kristofvl/NetWirelessIMU/Reference/nRF54L01_Reference/nRF_Castellations/nRF_C2.jpg

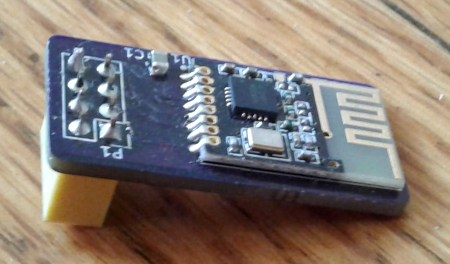
Reference/nRF54L01_Reference/nRF_Castellations/nRF_C2.jpg
