kristofvl/NetWirelessIMU/Reference/nRF54L01_Reference/nRF_Castellations/nRF_C1.jpg

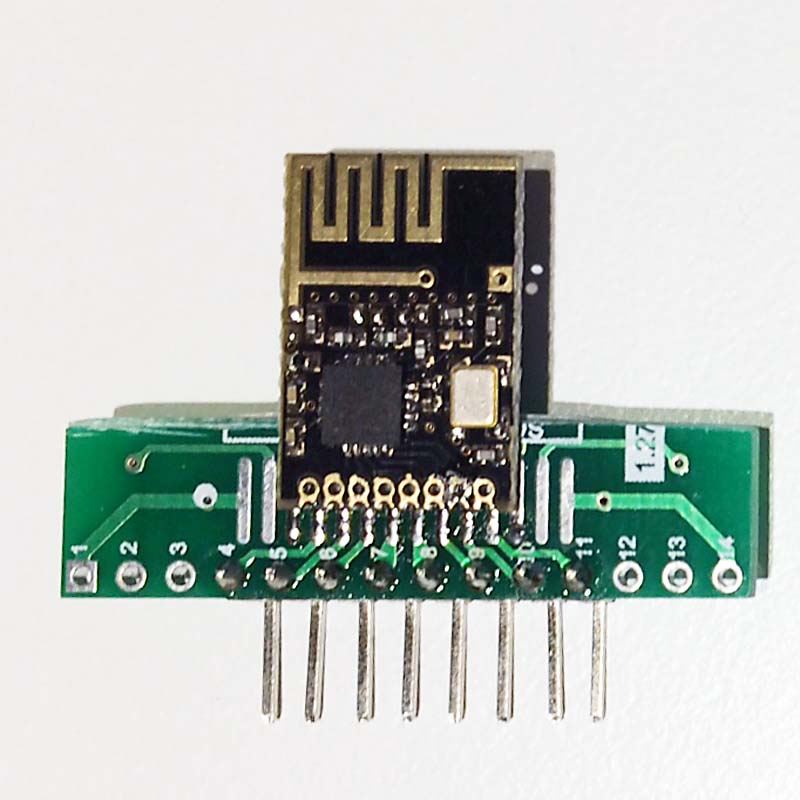
Reference/nRF54L01_Reference/nRF_Castellations/nRF_C1.jpg
