kristofvl/NetWirelessIMU/README.md

# Networked Wireless IMUs

A project started by Frederic Philips as a Masters thesis, now continued to update a hardware/software system of networked IMUs.
