kristofvl/NetWirelessIMU/Nextion/Nextion_Images/2_Nodes_Green.png

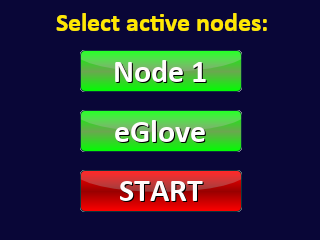
Nextion/Nextion_Images/2_Nodes_Green.png
