kristofvl/NetWirelessIMU/Nextion/Nextion_Images/2_Nodes_Grey.png

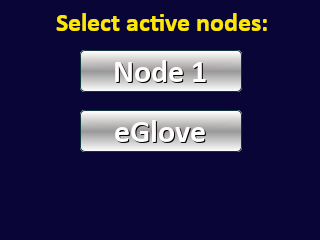
Nextion/Nextion_Images/2_Nodes_Grey.png
