kristofvl/NetWirelessIMU/Nextion/Nextion_Images/Abstact_Dark.jpg

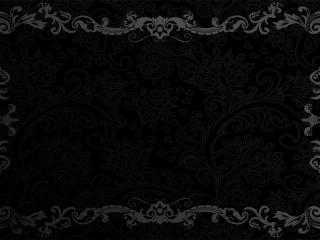
Nextion/Nextion_Images/Abstact_Dark.jpg
