kristofvl/NetWirelessIMU/Nextion/Nextion_Images/eGlove.png

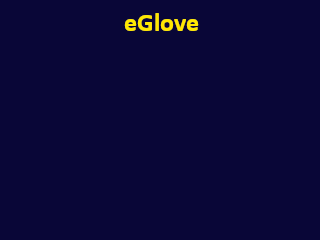
Nextion/Nextion_Images/eGlove.png
