kristofvl/NetWirelessIMU/Nextion/Nextion_Images/Nextion_Blue.jpg

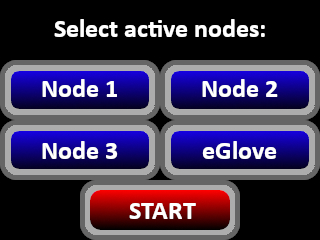
Nextion/Nextion_Images/Nextion_Blue.jpg
