kristofvl/NetWirelessIMU/Nextion/Nextion_Images/Nextion_Green.jpg

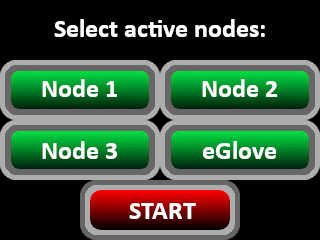
Nextion/Nextion_Images/Nextion_Green.jpg
