kristofvl/NetWirelessIMU/Nextion/Nextion_Images/Node1_eGlove.png

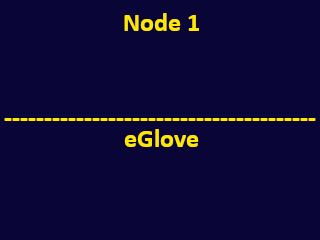
Nextion/Nextion_Images/Node1_eGlove.png
