kristofvl/NetWirelessIMU/PCB/Reference_PCBs/ATmega32U4_PCB/Adafruit_Feather_32u4_Basic_Proto/Adafruit_Feather_32u4_Schematic.png

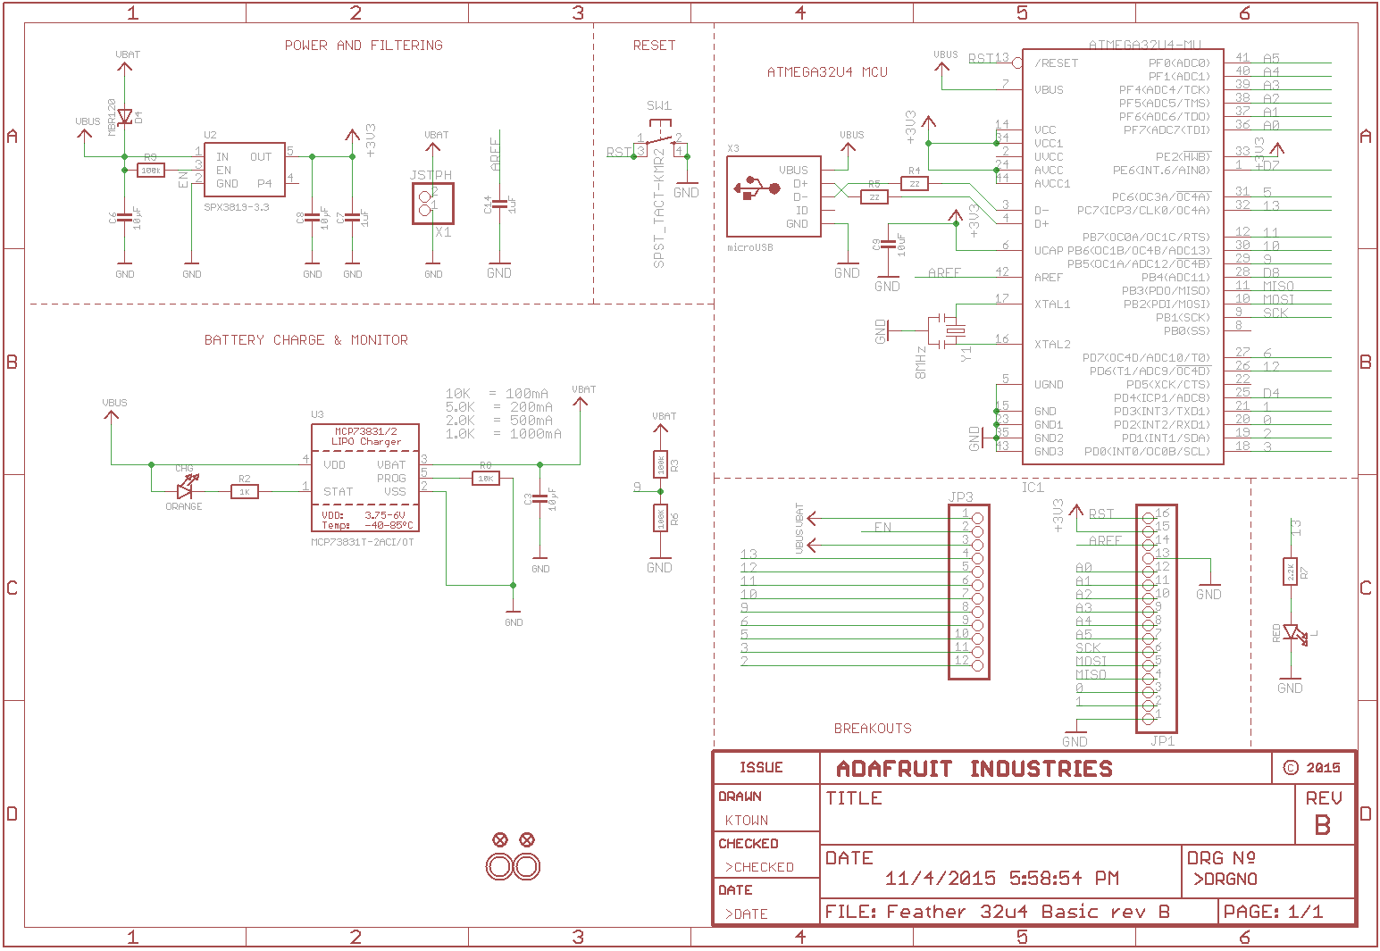
PCB/Reference_PCBs/ATmega32U4_PCB/Adafruit_Feather_32u4_Basic_Proto/Adafruit_Feather_32u4_Schematic.png
