kristofvl/NetWirelessIMU/PCB/Reference_PCBs/MCP73831_LiPo_Charger_PCB/Adafruit_MiniLipo/Adafruit_MiniLipo_Schematic.png

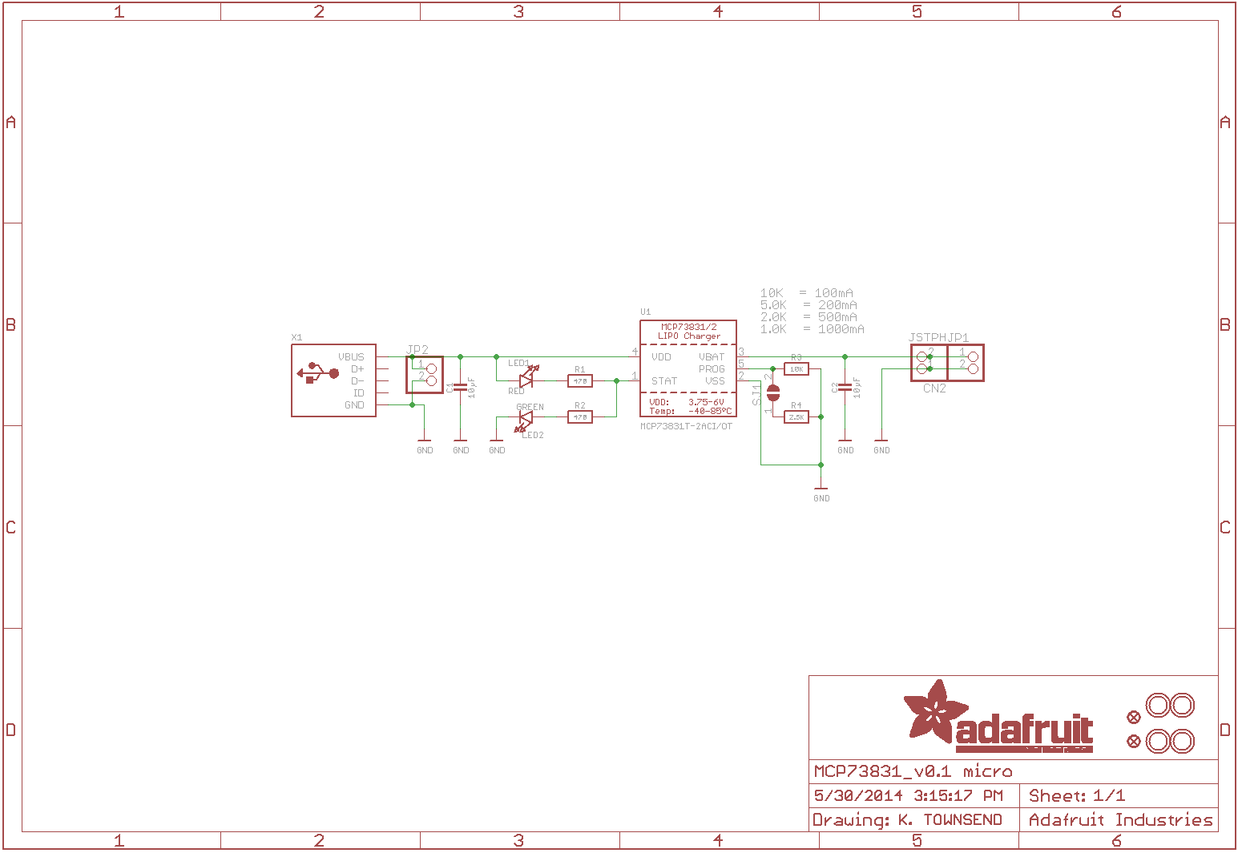
PCB/Reference_PCBs/MCP73831_LiPo_Charger_PCB/Adafruit_MiniLipo/Adafruit_MiniLipo_Schematic.png
