kristofvl/NetWirelessIMU/Reference/BNO055_Reference/BNO055_Shuttleboard_Schematic.png

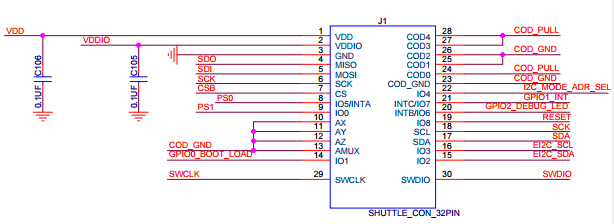
Reference/BNO055_Reference/BNO055_Shuttleboard_Schematic.png
