kristofvl/NetWirelessIMU/Reference/BNO055_Reference/I2C_connection_diagram.png

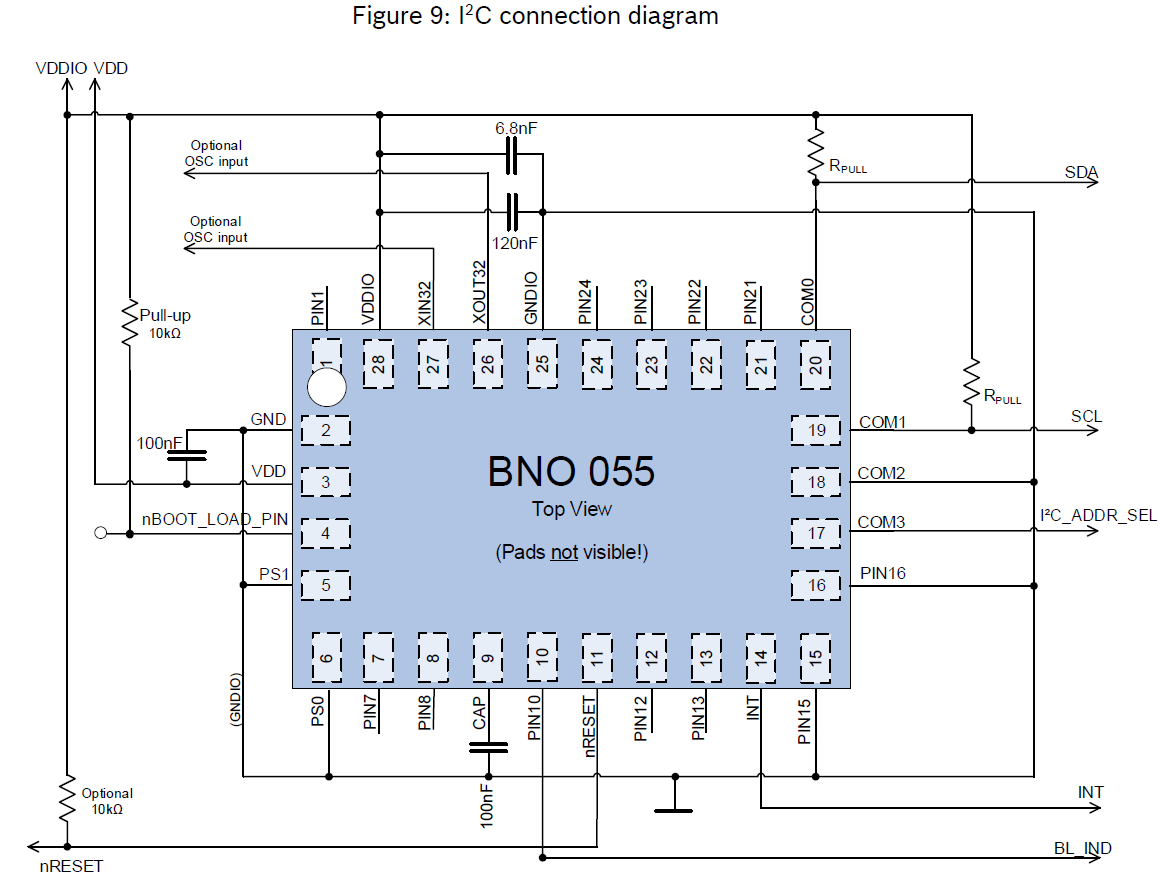
Reference/BNO055_Reference/I2C_connection_diagram.png
