kristofvl/NetWirelessIMU/Python_Reader/Recordings/calibration.csv

Sensor | 0 | 7 | wrist | OrientationAcceleration
Sensor | 1 | 7 | palm | OrientationAcceleration
Sensor | 2 | 7 | thumb | OrientationAcceleration
Sensor | 3 | 7 | index | OrientationAcceleration
Sensor | 4 | 7 | mid | OrientationAcceleration
Sensor | 5 | 7 | ring | OrientationAcceleration
Sensor | 6 | 7 | pinky | OrientationAcceleration
0 | 0 | -0.6142578125 | 0.734375 | 0.23187255859375 | -0.17218017578125 | 0.03 | -0.06 | -0.17
1 | 5 | 0.652099609375 | -0.65484619140625 | -0.24444580078125 | 0.29351806640625 | 0.2 | -0.03 | -0.1
2 | 6 | 0.5740966796875 | -0.774658203125 | 0.00372314453125 | -0.26507568359375 | 0.02 | 0.32 | -0.07
0 | 7 | -0.61419677734375 | 0.73431396484375 | 0.23199462890625 | -0.17236328125 | 0.02 | -0.05 | -0.15
3 | 11 | 0.7589111328125 | -0.54754638671875 | -0.30389404296875 | 0.1787109375 | 0.28 | -0.05 | -0.29
4 | 11 | 0.808349609375 | -0.50946044921875 | -0.2322998046875 | 0.18170166015625 | 0.24 | 0.05 | -0.35
5 | 17 | 0.77496337890625 | -0.53076171875 | -0.28680419921875 | 0.1884765625 | 0.18 | 0.0 | -0.11
6 | 18 | -0.72760009765625 | 0.59716796875 | 0.1893310546875 | -0.279541015625 | 0.21 | 0.02 | -0.22
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
