kristofvl/NetWirelessIMU/Reference/nRF_test.pdf

nRF_TX_test | nRF_RX_test

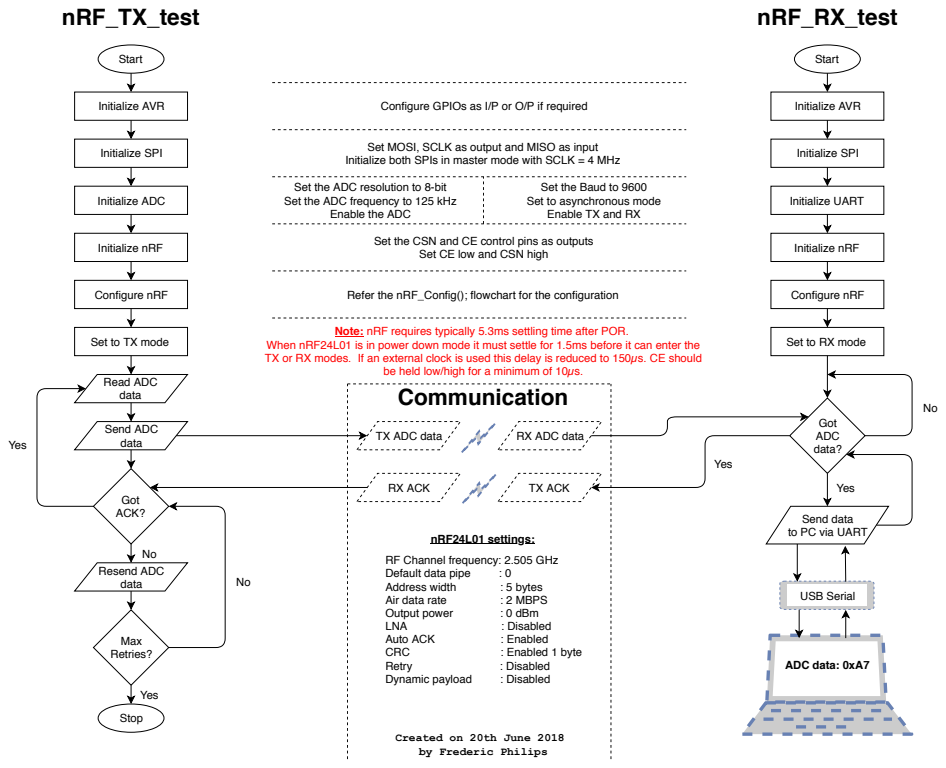
[picture p14: page 1]
Start; Initialize AVR; Initialize SPI; Initialize ADC; Initialize nRF; Configure nRF; Read ADC data; Send ADC data; Got ACK?; Max Retries?; Resend ADC data; Stop; Yes; Initialize UART; TX ADC data; RX ADC data; Got ADC data?; RX ACK; TX ACK; ADC data: 0xA7; USB Serial; Default data pipe; Address width; : 5 bytes; Air data rate; : 2 MBPS; Output power; : 0 dBm; LNA; : Disabled; Auto ACK; : Enabled; CRC; : Enabled 1 byte; Retry; Dynamic payload; nRF24L01 settings:

Configure GPIOs as I/P or O/P if required

Set MOSI, SCLK as output and MISO as input
Initialize both SPIs in master mode with SCLK = 4 MHz

Set the ADC resolution to 8-bit
Set the ADC frequency to 125 kHz

Set the Baud to 9600
Set to asynchronous mode
Enable TX and RX

Enable the ADC

Set the CSN and CE control pins as outputs

Set CE low and CSN high

Refer the nRF_Config(); flowchart for the configuration

Note: nRF requires typically 5.3ms settling time after POR.

Set to TX mode

Set to RX mode

When nRF24L01 is in power down mode it must settle for 1.5ms before it can enter the
TX or RX modes. If an external clock is used this delay is reduced to 150µs. CE should

be held low/high for a minimum of 10µs.
Communication

Send data
to PC via UART

RF Channel frequency: 2.505 GHz

Created on 20th June 2018
by Frederic Philips
