kristofvl/NetWirelessIMU/PCB/Reference_PCBs/MAX17043_Battery_Gauge_PCB/MAX17043_Schematic.pdf

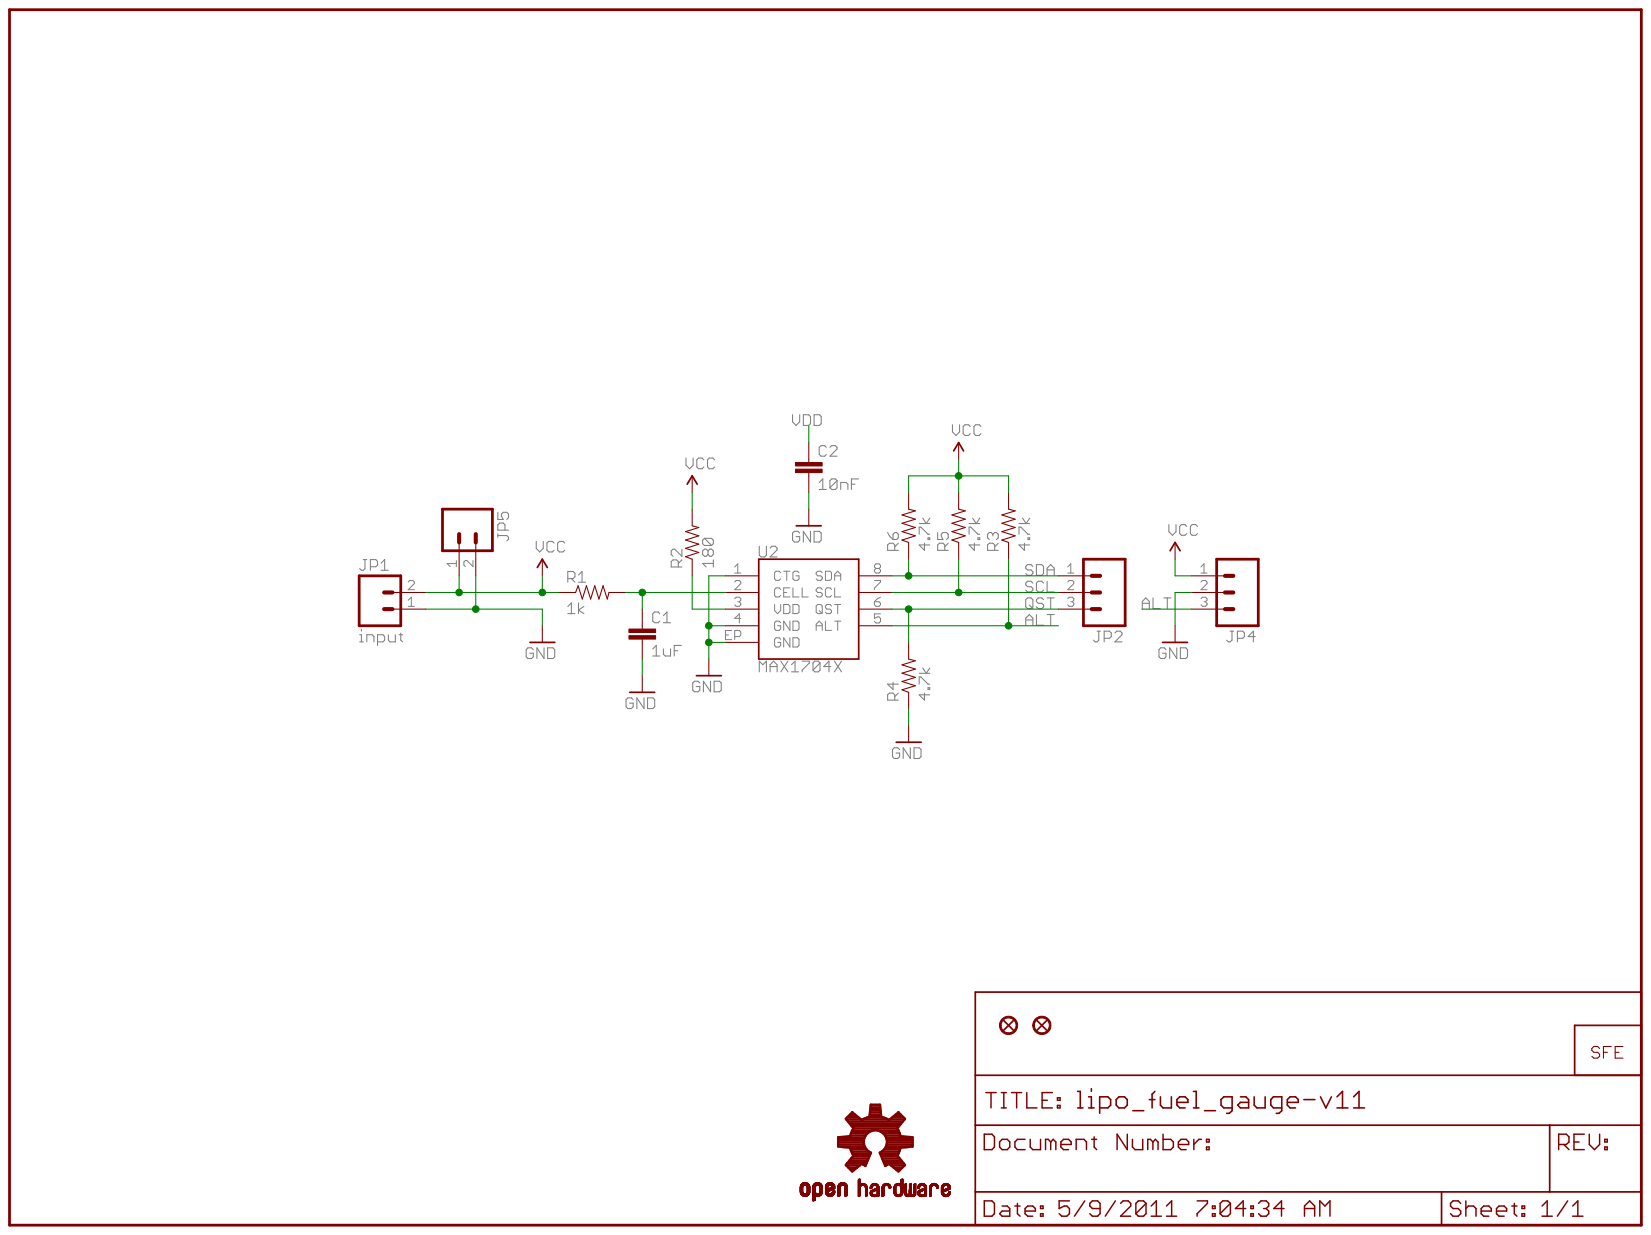
[picture p15: page 1]
