kristofvl/NetWirelessIMU/PCB/Reference_PCBs/nRF24L01+_PCB/Sparkfun_nRF24L01+_Schematic.pdf

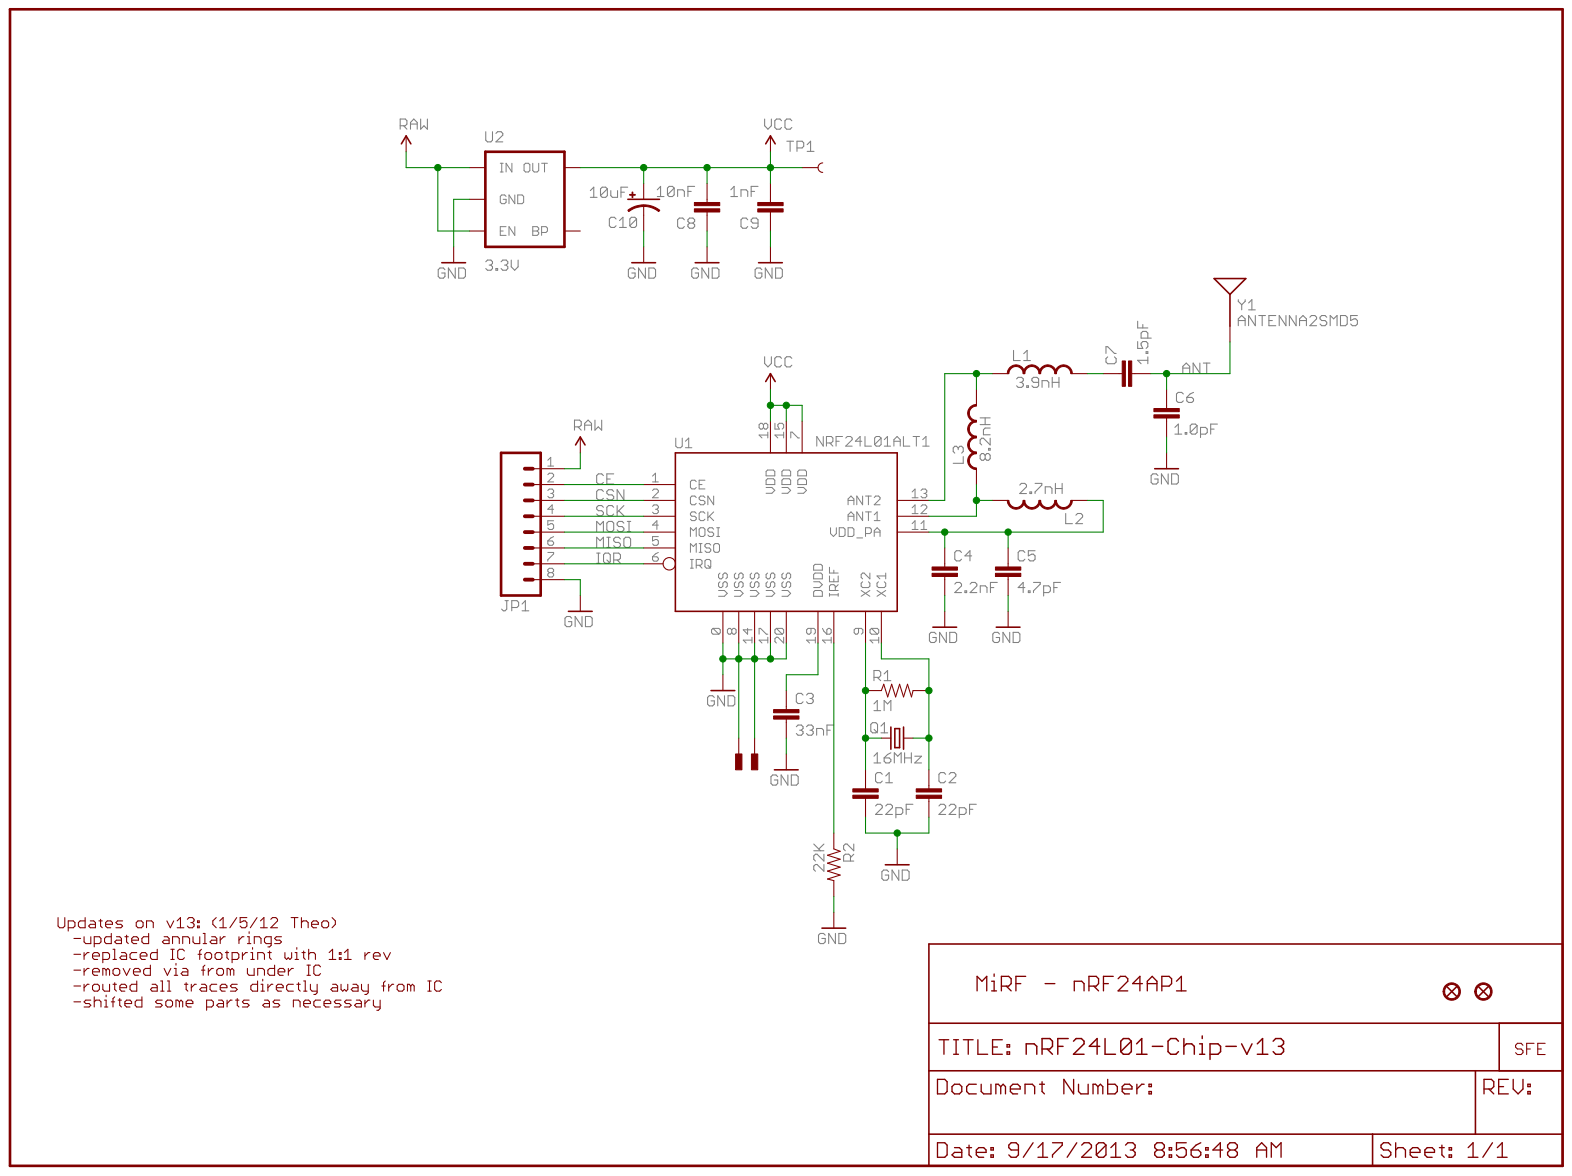
[picture p16: page 1]
