kristofvl/NetWirelessIMU/PCB/Reference_PCBs/ATmega32U4_PCB/Sparkfun_Fio_v3_ATmega32U4/Sparkfun_Fio_Schematic.pdf

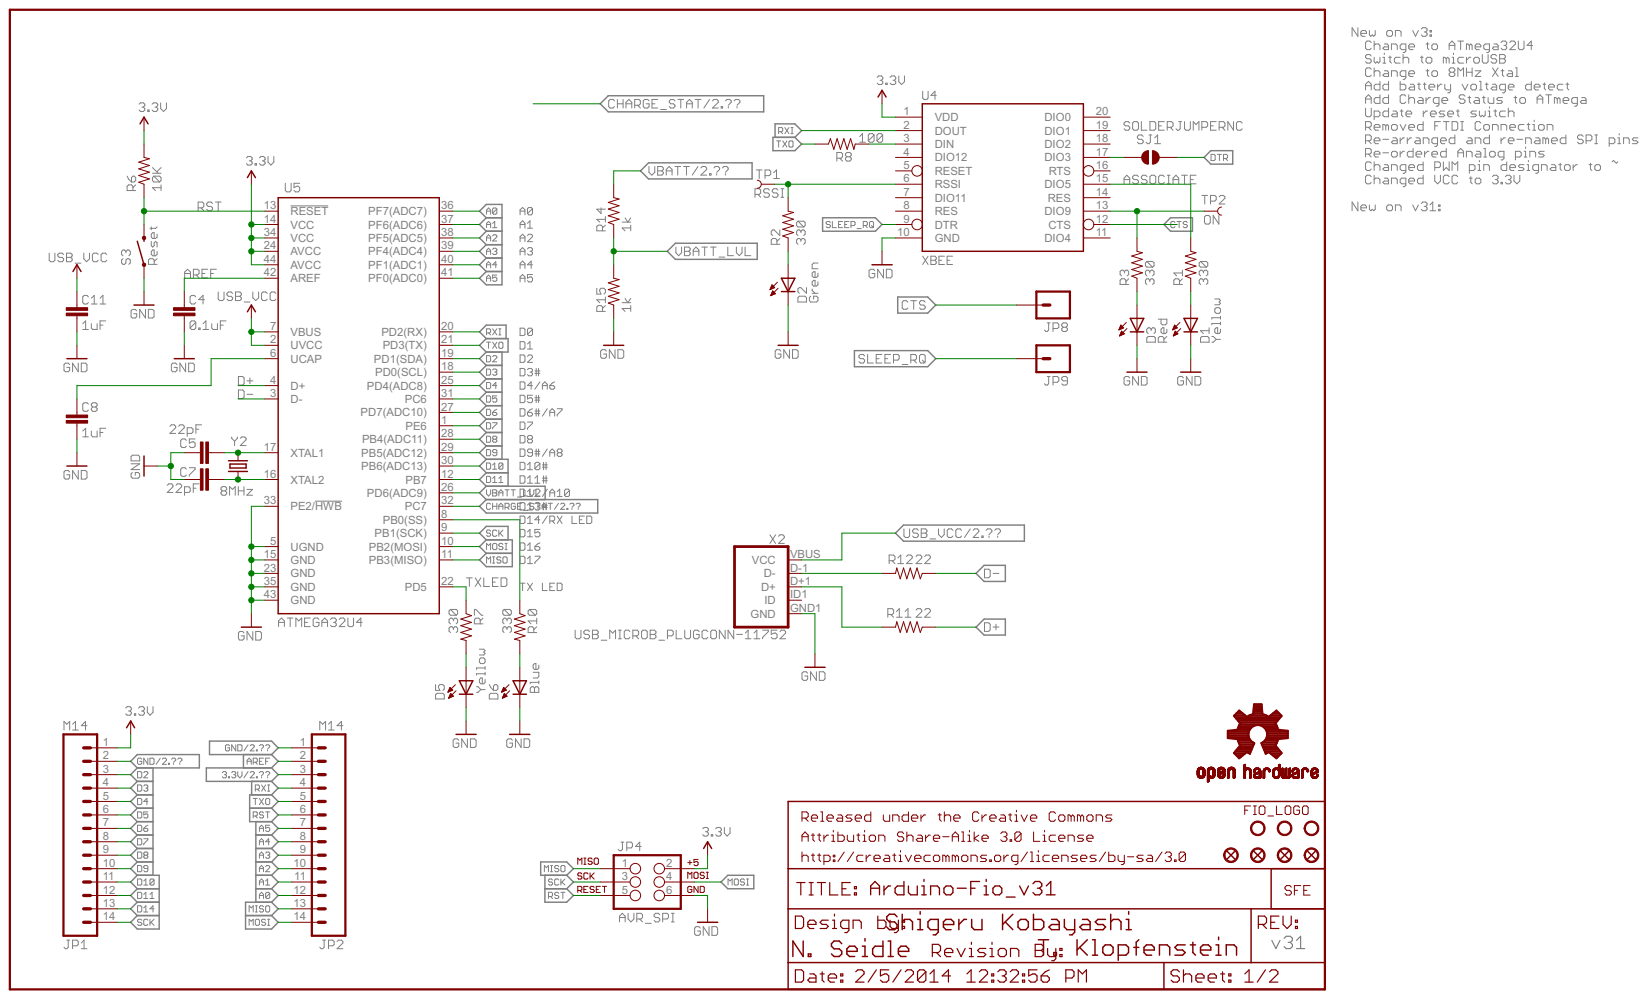
[picture p17: page 1]

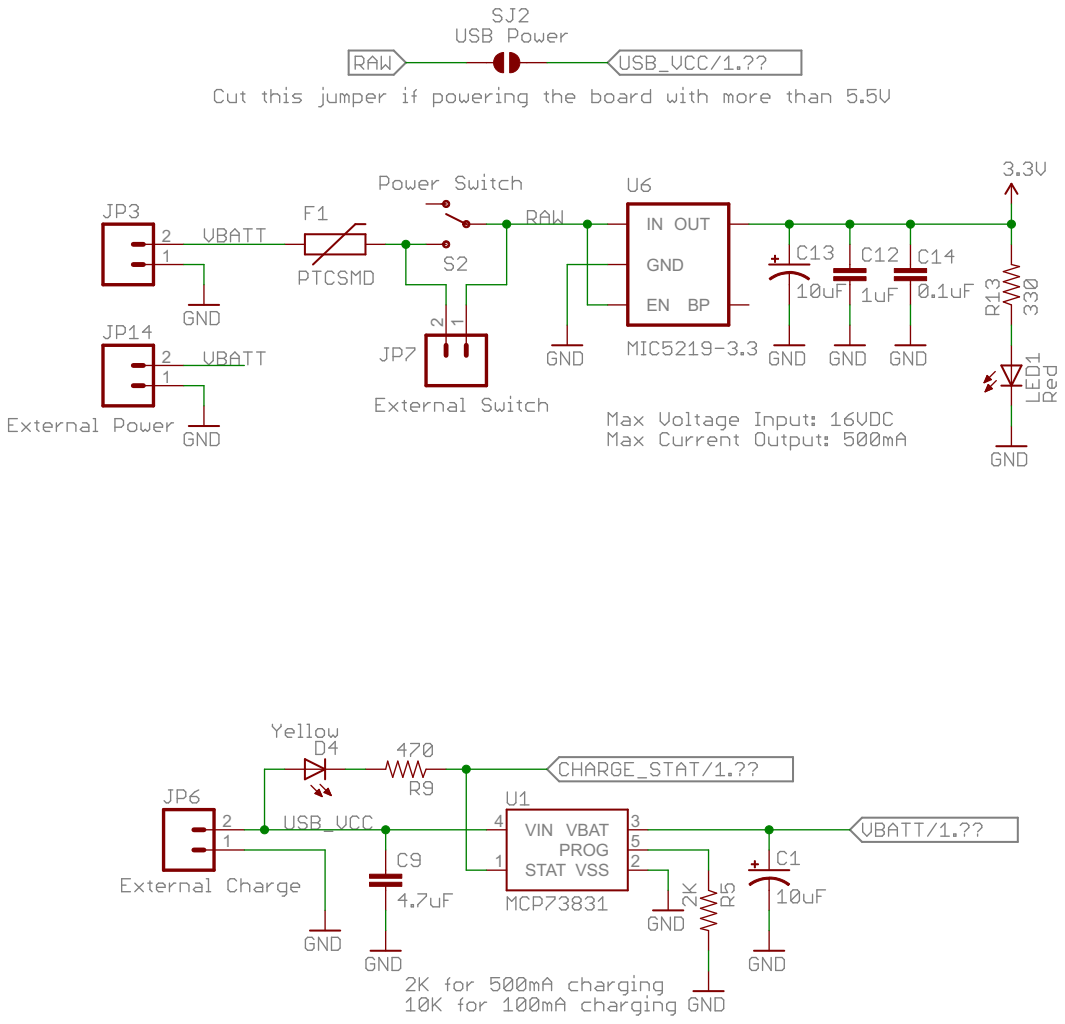
[picture p18: page 2]
