kristofvl/NetWirelessIMU/PCB/Reference_PCBs/MCP73831_LiPo_Charger_PCB/Sparkfun_MiniLipo/Sparkfun_MiniLipo_Schematic.pdf

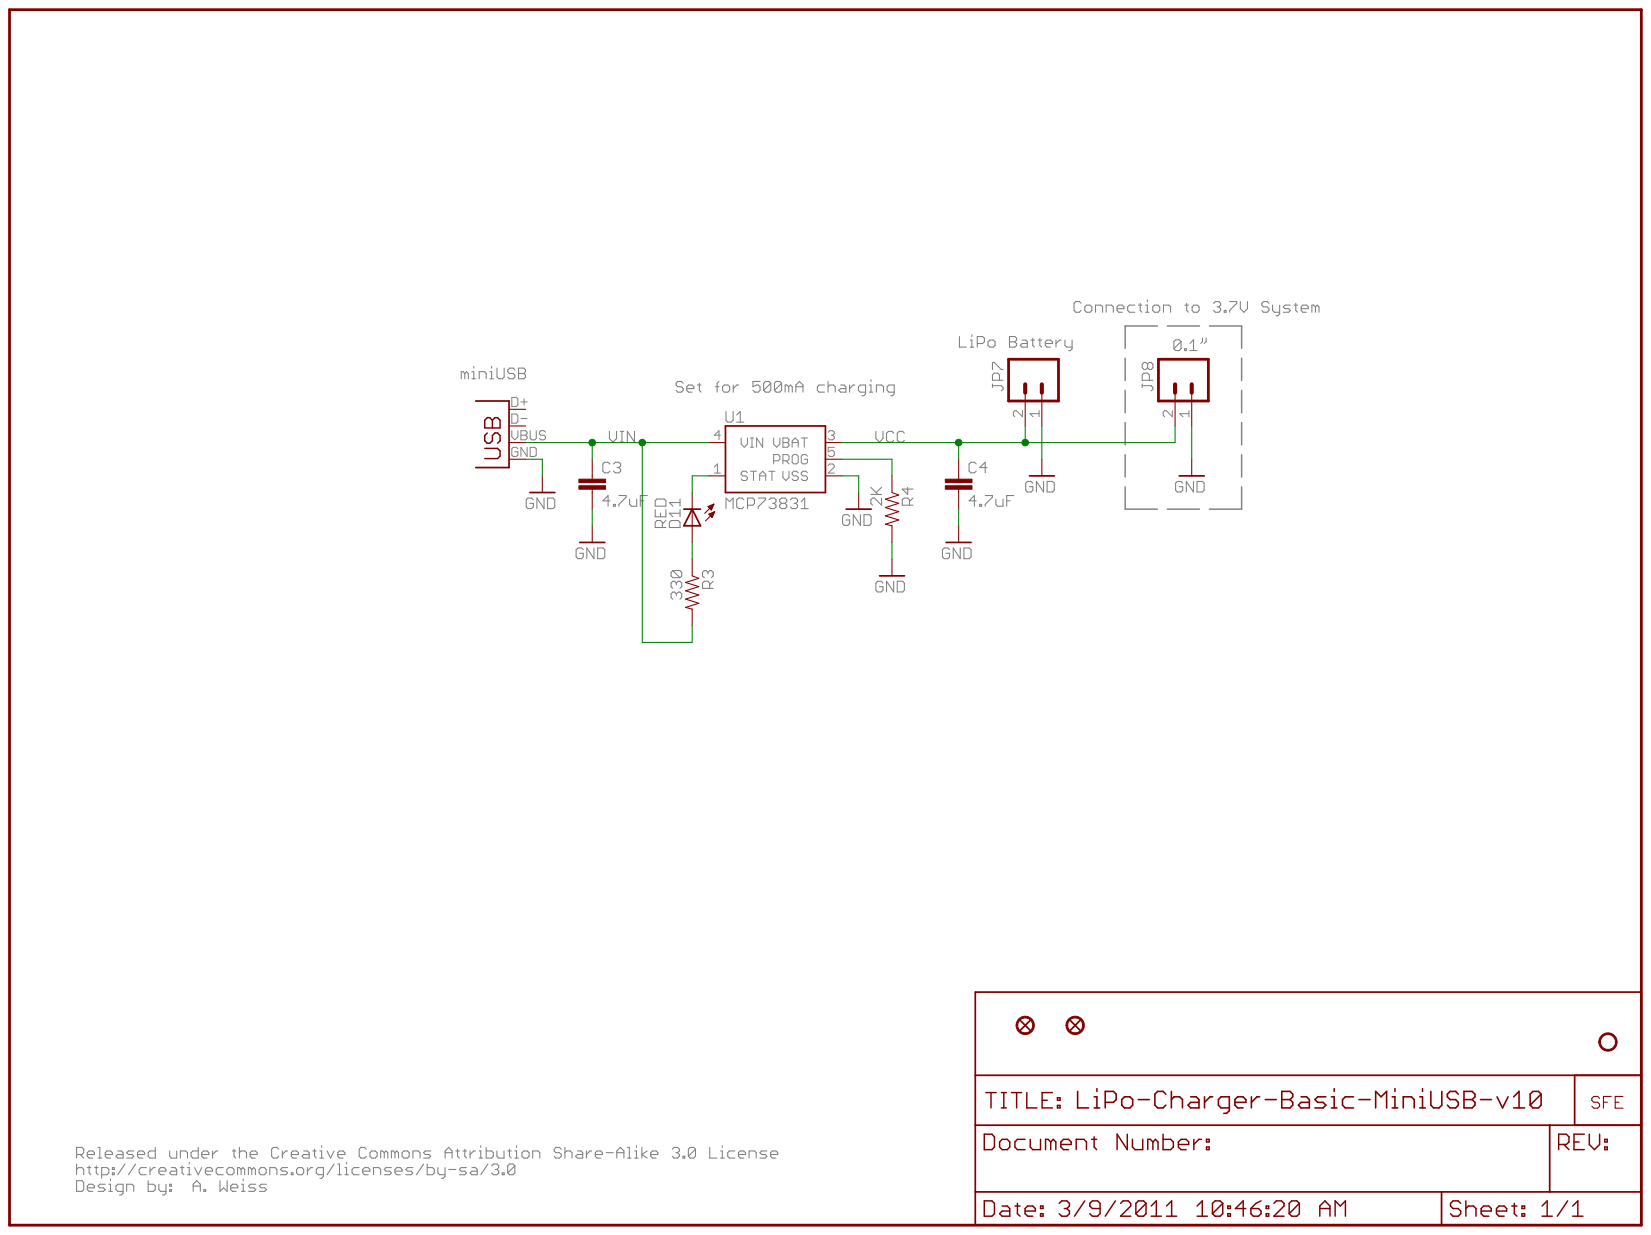
[picture p19: page 1]
