kristofvl/NetWirelessIMU/PCB/PCB_v_2.0/BS_Shield/bs_shield.pdf

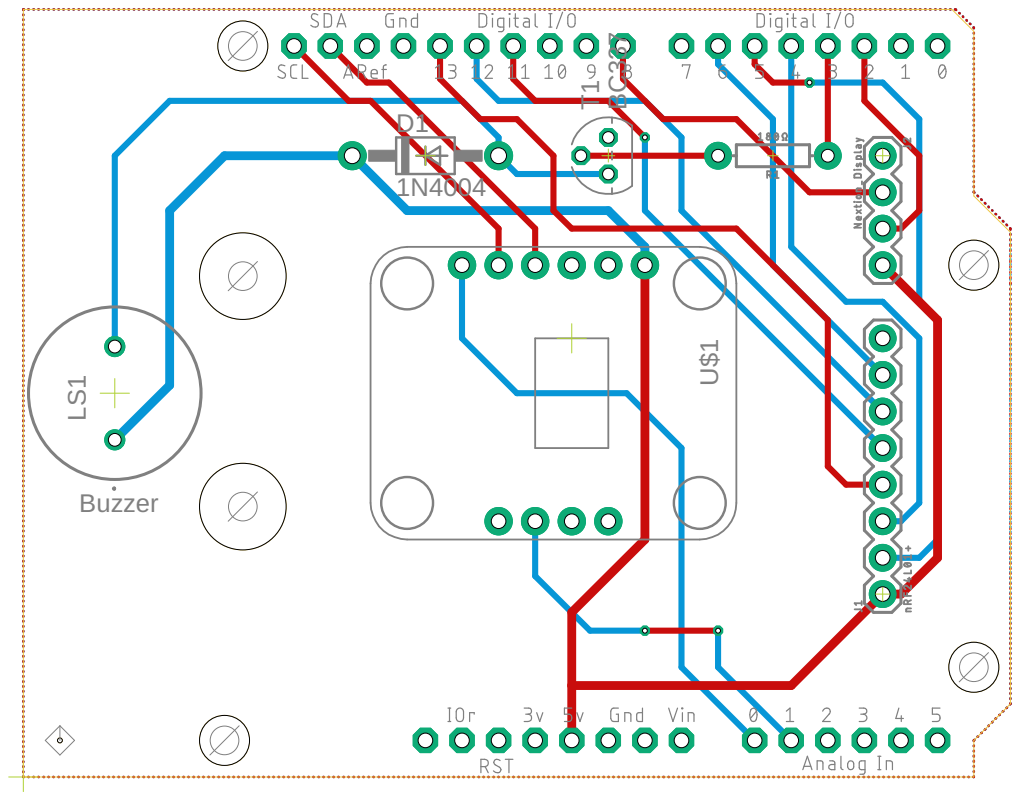
[picture p20: page 1]
