kristofvl/NetWirelessIMU/PCB/PCB_v_2.0/IMU_hand/imu_hand.pdf

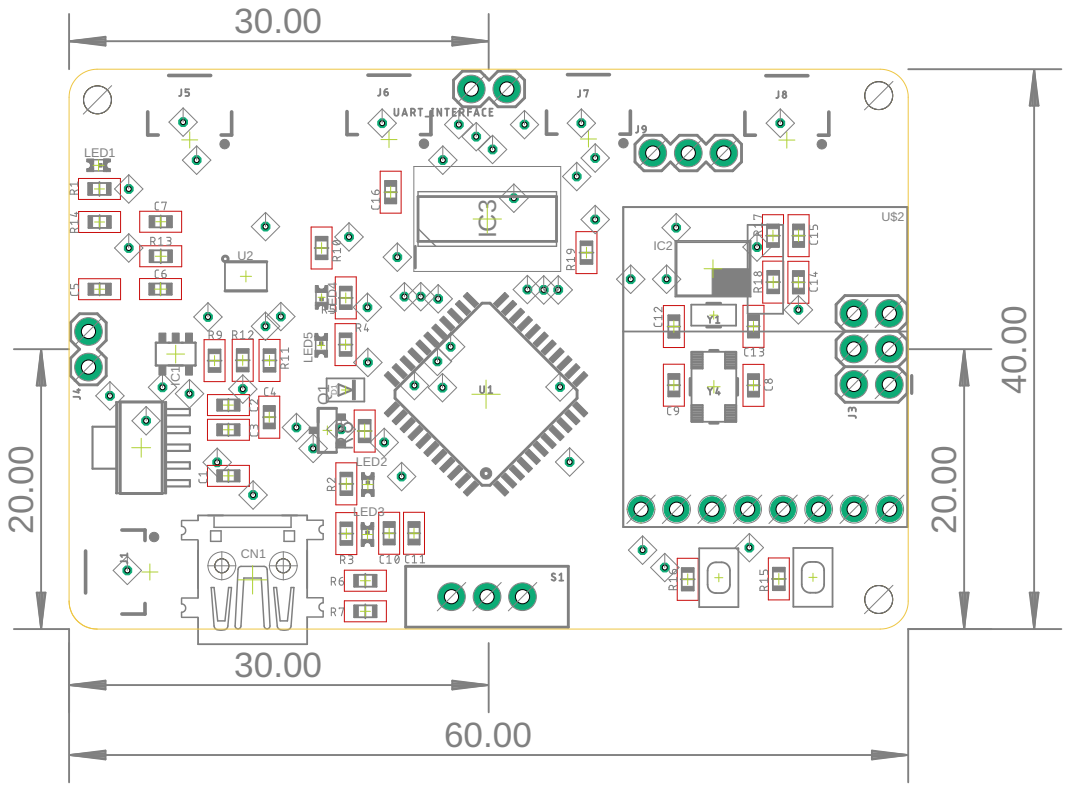
[picture p21: page 1]
