kristofvl/NetWirelessIMU/PCB/PCB_v_2.0/IMU_node/imu_node.pdf

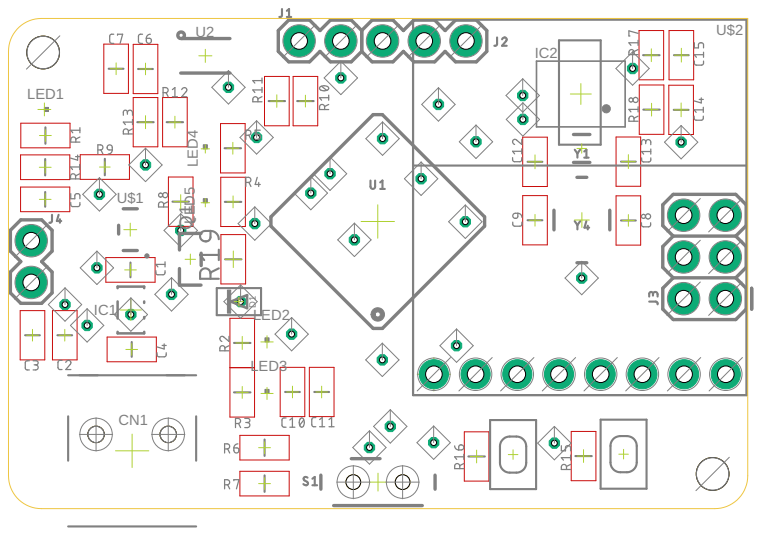
[picture p22: page 1]
