kristofvl/NetWirelessIMU/PCB/PCB_v_1.0/IMU_node/imu_node.brd

## EAGLE design PCB/PCB_v_1.0/IMU_node/imu_node.brd (2018-09-14, an earlier design)

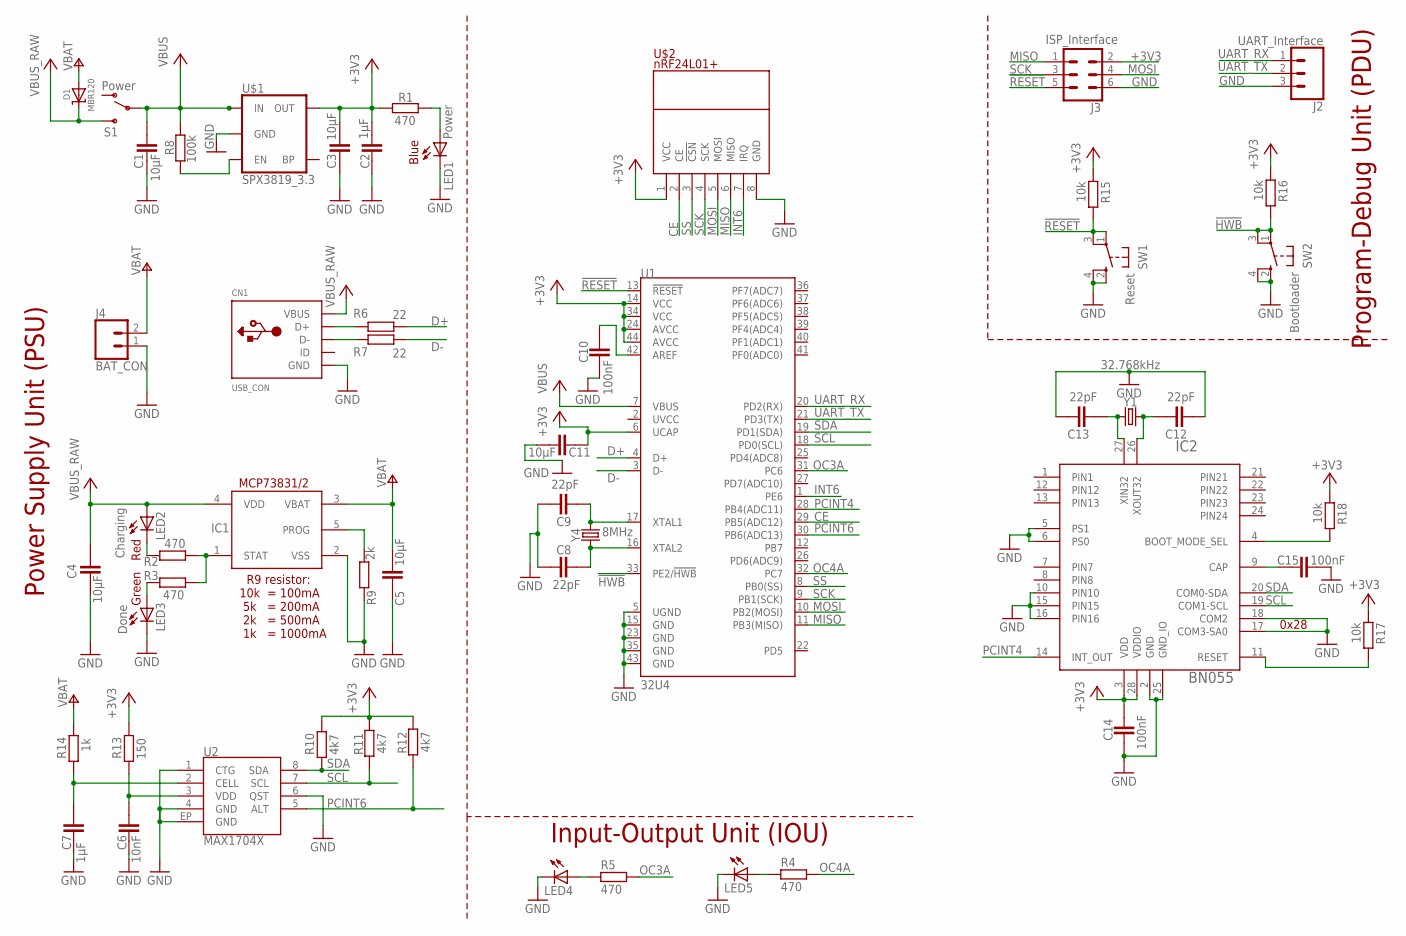
[picture p23: schematic imu_node.sch]

Parts:
C1, C3, C4, C5, C11: 10µF; CAPC1608X92N
C2, C7: 1µF; CAPC1608X92N
C6: 10nF; CAPC1608X92N
C8, C9, C12, C13: 22pF; CAPC1608X92N
C10, C14, C15: 100nF; CAPC1608X92N
CN1: USB_CON; USB-MINIB
D1: MBR120; SOD-123FL
IC1: MCP73831/OT; SOT23-5L
IC2: BN055; LGA-28_3.80X5.20/0.5
J2: UART_Interface; 1X03
J3: ISP_Interface; 2X3
J4: BAT_CON; 1X02
LED1: Power; CHIPLED_0603
LED2: Charging; CHIPLED_0603
LED3: Done; CHIPLED_0603
LED4, LED5: LEDCHIPLED_0603; CHIPLED_0603
R1, R2, R3, R4, R5: 470; RESC1608X55N
R6, R7: 22; RESC1608X55N
R8: 100k; RESC1608X55N
R9: 2k; RESC1608X55N
R10, R11, R12: 4k7; RESC1608X55N
R13: 150; RESC1608X55N
R14: 1k; RESC1608X55N
R15, R16, R17, R18: 10k; RESC1608X55N
S1: Power; SWITCH_SPST_SMD_A
SW1: Reset; KMR2
SW2: Bootloader; KMR2
U1: 32U4; TQFP44
U2: MAX1704X; TDFN-8
U$1: SPX3819_3.3; SOT23-5
U$2: nRF24L01+; 6-PIN-BREAKOUT
Y1: 32.768kHz; CRYSTAL-SMD-3.2X1.5MM
Y4: 8MHz; CRYSTAL-SMD-5X3.2-4PAD

Connections:
!HWB!: R16.2, SW2.1, SW2.3 (P1), U1.33 (PE2/!HWB)
!RESET!: J3.5, R15.2, SW1.1, SW1.3 (P1), U1.13 (!RESET)
+3V3: C2.2, C3.2, C11.1, C14.1, IC2.3 (VDD), IC2.28 (VDDIO), J3.2, R1.2, R10.1, R11.1, R12.1, R13.1, R15.1, R16.1, R17.1, R18.1, U1.6 (UCAP), U1.14 (VCC), U1.24 (AVCC), U1.34 (VCC), U1.44 (AVCC), U$1.5 (OUT), U$2.1 (VCC)
CE: U1.29 (PB5(ADC12)), U$2.2 (CE)
D+: R6.1, U1.4 (D+)
D-: R7.1, U1.3 (D-)
GND: C1.1, C2.1, C3.1, C4.1, C5.1, C6.1, C7.1, C8.2, C9.2, C10.2, C11.2, C12.1, C13.2, C14.2, C15.2, CN1.GND, IC1.2 (VSS), IC2.2 (GND), IC2.5 (PS1), IC2.6 (PS0), IC2.10 (PIN10), IC2.15 (PIN15), IC2.16 (PIN16), IC2.17 (COM3-SA0), IC2.18 (COM2), IC2.25 (GND_IO), J2.3, J3.6, J4.1, LED1.C, LED3.C, LED4.C, LED5.C, R9.2, SW1.2 (S), SW1.4 (S1), SW2.2 (S), SW2.4 (S1), U1.5 (UGND), U1.15 (GND), U1.23 (GND), U1.35 (GND), U1.43 (GND), U2.1 (CTG), U2.4 (GND), U2.6 (QST), U2.EP (GND), U$1.2 (GND), U$2.8 (GND)
INT6: U1.1 (PE6), U$2.7 (IRQ)
MISO: J3.1, U1.11 (PB3(MISO)), U$2.6 (MISO)
MOSI: J3.4, U1.10 (PB2(MOSI)), U$2.5 (MOSI)
unnamed: CN1.D+, R6.2
unnamed: CN1.D-, R7.2
unnamed: IC1.5 (PROG), R9.1
unnamed: LED2.C, R2.2
unnamed: R8.2, U$1.3 (EN)
unnamed: C13.1, IC2.27 (XIN32), Y1.P$1 (1)
unnamed: LED1.A, R1.1
unnamed: IC1.1 (STAT), R2.1, R3.1
unnamed: LED3.A, R3.2
unnamed: C9.1, U1.17 (XTAL1), Y4.3 (2)
unnamed: C8.1, U1.16 (XTAL2), Y4.1
unnamed: C10.1, U1.42 (AREF)
unnamed: C6.2, R13.2, U2.3 (VDD)
unnamed: C7.2, R14.2, U2.2 (CELL)
unnamed: LED4.A, R5.1
unnamed: C12.2, IC2.26 (XOUT32), Y1.P$2 (2)
unnamed: LED5.A, R4.1
unnamed: IC2.11 (RESET), R17.2
unnamed: C15.1, IC2.9 (CAP)
unnamed: IC2.4 (BOOT_MODE_SEL), R18.2
OC3A: R5.2, U1.31 (PC6)
OC4A: R4.2, U1.32 (PC7)
PCINT4: IC2.14 (INT_OUT), U1.28 (PB4(ADC11))
PCINT6: R12.2, U1.30 (PB6(ADC13)), U2.5 (ALT)
SCK: J3.3, U1.9 (PB1(SCK)), U$2.4 (SCK)
SCL: IC2.19 (COM1-SCL), R11.2, U1.18 (PD0(SCL)), U2.7 (SCL)
SDA: IC2.20 (COM0-SDA), R10.2, U1.19 (PD1(SDA)), U2.8 (SDA)
SS: U1.8 (PB0(SS)), U$2.3 (!CSN!)
UART_RX: J2.1, U1.20 (PD2(RX))
UART_TX: J2.2, U1.21 (PD3(TX))
VBAT: C5.2, D1.A, IC1.3 (VBAT), J4.2, R14.1
VBUS: C1.2, R8.1, S1.2, U1.7 (VBUS), U$1.1 (IN)
VBUS_RAW: C4.2, CN1.VBUS, D1.C, IC1.4 (VDD), LED2.A, S1.3 (S)

Notes on the sheet:
Power Supply Unit (PSU)
Blue
Red
Green
R9 resistor: 10k = 100mA 5k = 200mA 2k = 500mA 1k = 1000mA
nRF24L01+
Program-Debug Unit (PDU)
Input-Output Unit (IOU)
0x28

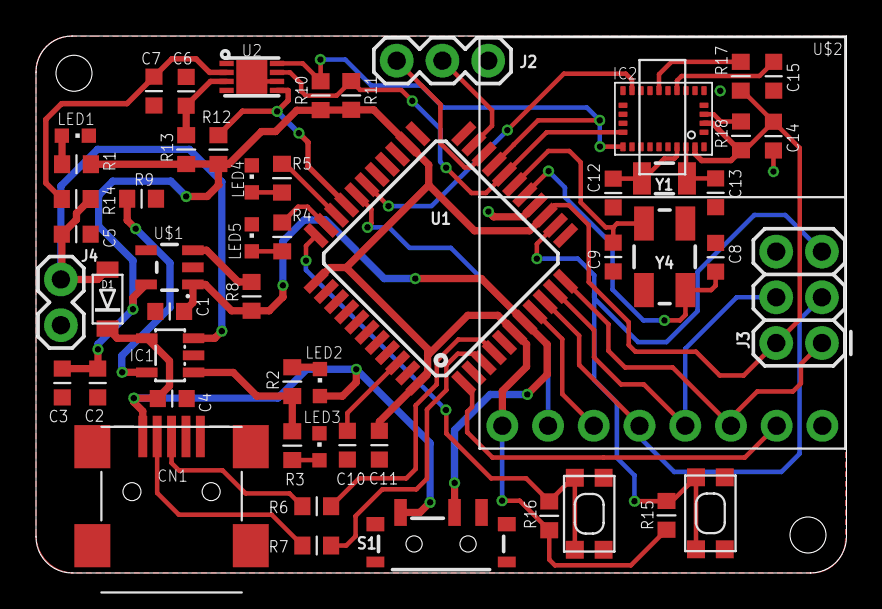
[picture p24: board imu_node.brd from above]

Board: 2 copper layers, 45.0 x 29.8 mm, 54 parts (0 on the bottom side), 43 nets.
