kristofvl/NetWirelessIMU/PCB/PCB_v_1.0/IMU_finger/imu_finger.brd

## EAGLE design PCB/PCB_v_1.0/IMU_finger/imu_finger.brd (2018-09-14, an earlier design)

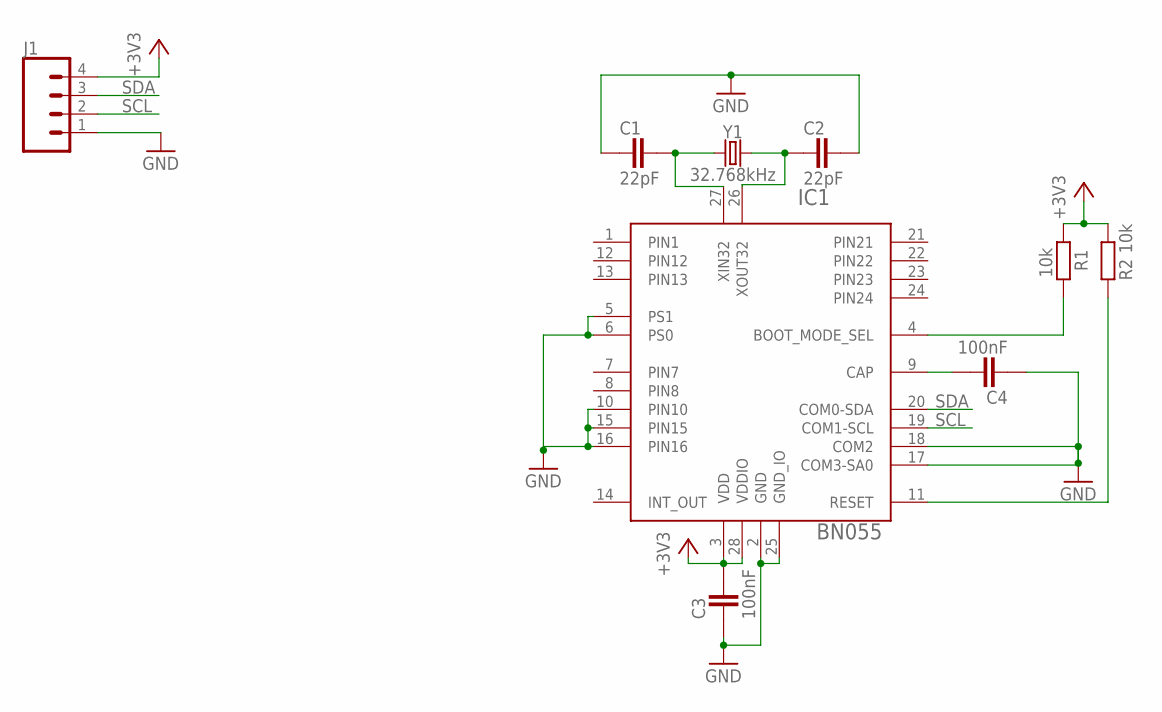
[picture p25: schematic imu_finger.sch]

Parts:
C1, C2: 22pF; CAPC1608X92N
C3, C4: 100nF; CAPC1608X92N
IC1: BN055; LGA-28_3.80X5.20/0.5
J1: CONN_04SMD2; 1X04_1MM_RA
R1, R2: 10k; RESC1608X55N
Y1: 32.768kHz; CRYSTAL-SMD-3.2X1.5MM

Connections:
+3V3: C3.2, IC1.3 (VDD), IC1.28 (VDDIO), J1.4, R1.1, R2.1
GND: C1.1, C2.2, C3.1, C4.1, IC1.2 (GND), IC1.5 (PS1), IC1.6 (PS0), IC1.10 (PIN10), IC1.15 (PIN15), IC1.16 (PIN16), IC1.17 (COM3-SA0), IC1.18 (COM2), IC1.25 (GND_IO), J1.1
unnamed: IC1.11 (RESET), R2.2
unnamed: IC1.4 (BOOT_MODE_SEL), R1.2
unnamed: C4.2, IC1.9 (CAP)
unnamed: C2.1, IC1.26 (XOUT32), Y1.P$2 (2)
unnamed: C1.2, IC1.27 (XIN32), Y1.P$1 (1)
SCL: IC1.19 (COM1-SCL), J1.2
SDA: IC1.20 (COM0-SDA), J1.3

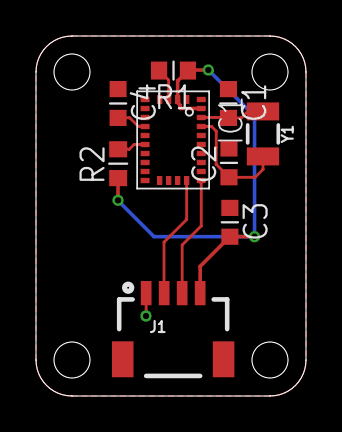
[picture p26: board imu_finger.brd from above]

Board: 2 copper layers, 15.0 x 20.0 mm, 9 parts (0 on the bottom side), 9 nets.
