kristofvl/NetWirelessIMU/PCB/PCB_v_2.0/BS_Shield/bs_shield.brd

## EAGLE design PCB/PCB_v_2.0/BS_Shield/bs_shield.brd (2019-04-10)

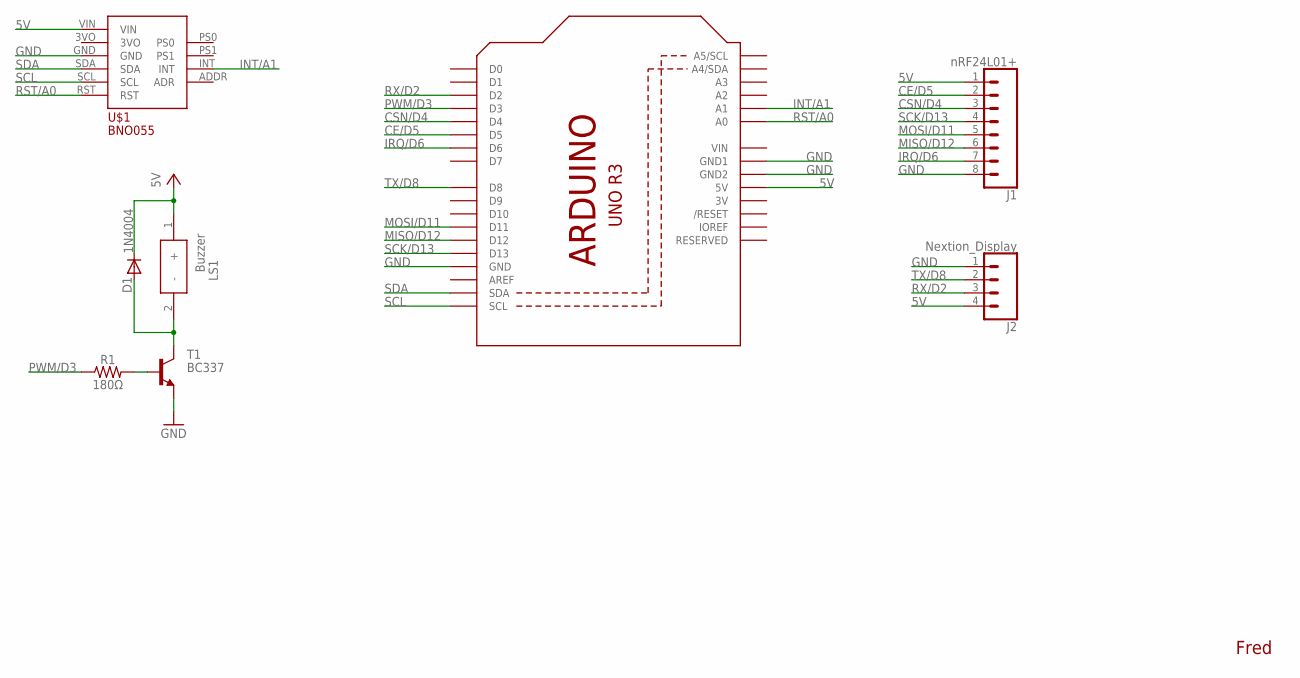
[picture p27: schematic bs_shield.sch]

Parts:
D1: 1N4004; DO41-10
J1: nRF24L01+; 1X08
J2: Nextion_Display; 1X04
LS1: Buzzer; CEM-1203(42)
R1: 180Ω; AXIAL-0.3
T1: BC337; TO92
U1: ARDUINOR3-DIMENSION; ARDUINOR3
U$1: BNO055; BB10

Connections:
3V: U1.3V
5V: D1.C, J1.1, J2.4, LS1.1 (+), U1.5V, U$1.VIN
CE/D5: J1.2, U1.D5
CSN/D4: J1.3, U1.D4
GND: J1.8, J2.1, T1.1 (E), U1.GND, U1.GND1, U1.GND2, U$1.GND
INT/A1: U1.A1, U$1.INT
IRQ/D6: J1.7, U1.D6
MISO/D12: J1.6, U1.D12
MOSI/D11: J1.5, U1.D11
unnamed: R1.P$2 (2), T1.2 (B)
unnamed: D1.A, LS1.2 (-), T1.3 (C)
PWM/D3: R1.P$1 (1), U1.D3
RST/A0: U1.A0, U$1.RST
RX/D2: J2.3, U1.D2
SCK/D13: J1.4, U1.D13
SCL: U1.SCL, U$1.SCL
SDA: U1.SDA, U$1.SDA
TX/D8: J2.2, U1.D8
VIN: U1.VIN

Notes on the sheet:
Fred

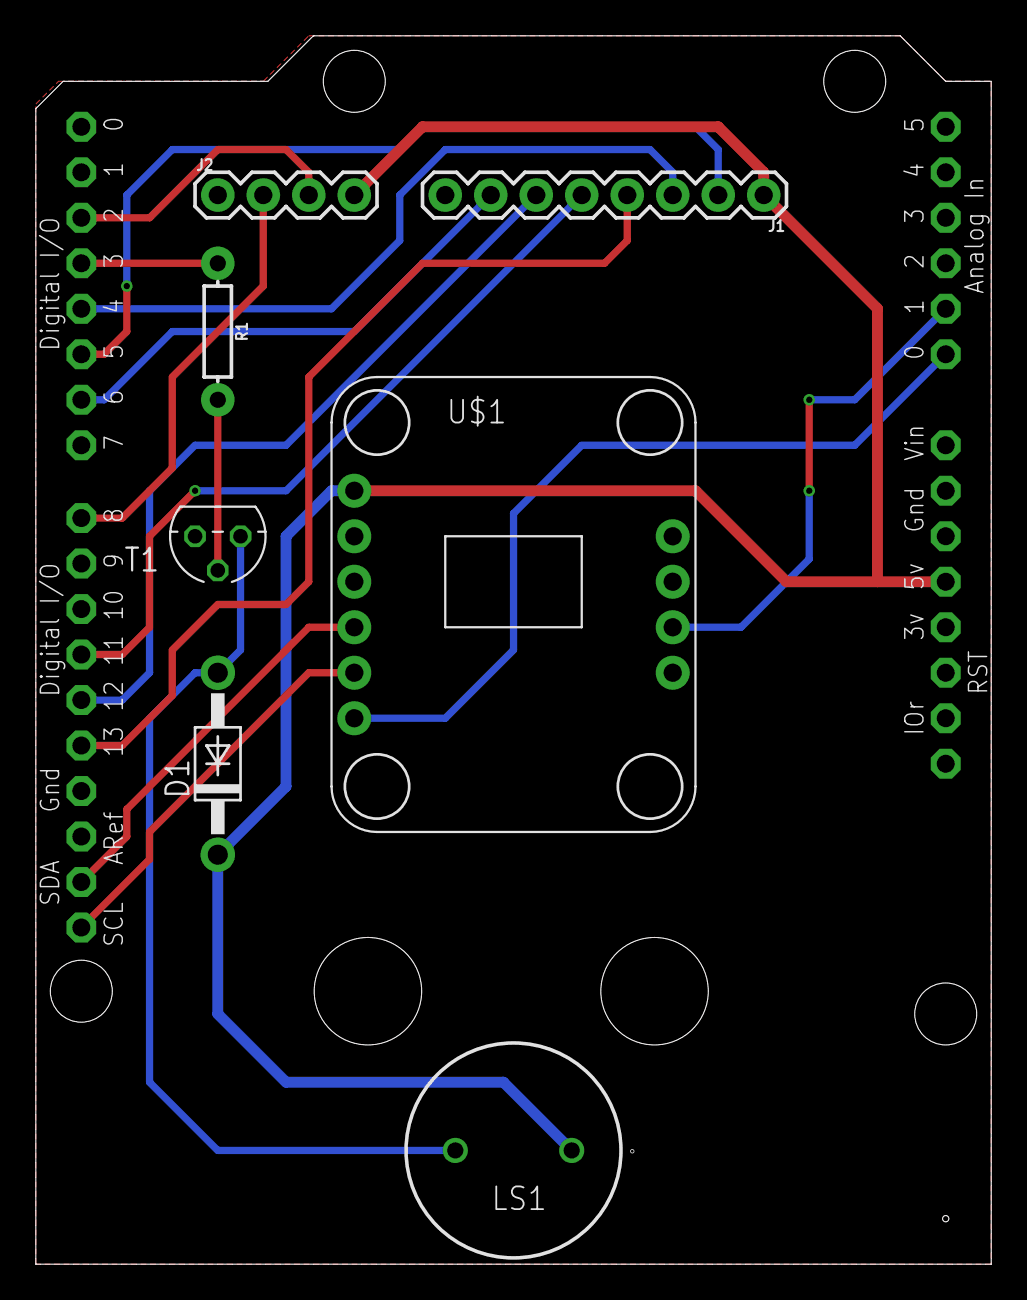
[picture p28: board bs_shield.brd from above]

Board: 2 copper layers, 53.3 x 68.6 mm, 8 parts (0 on the bottom side), 17 nets.
