kristofvl/NetWirelessIMU/PCB/Reference_PCBs/MCP73831_LiPo_Charger_PCB/Adafruit_MiniLipo/Adafruit_MiniLipo_Eagle_Files/Adafruit MiniLipo.brd

## EAGLE design PCB/Reference_PCBs/MCP73831_LiPo_Charger_PCB/Adafruit_MiniLipo/Adafruit_MiniLipo_Eagle_Files/Adafruit MiniLipo.brd (2018-08-24)

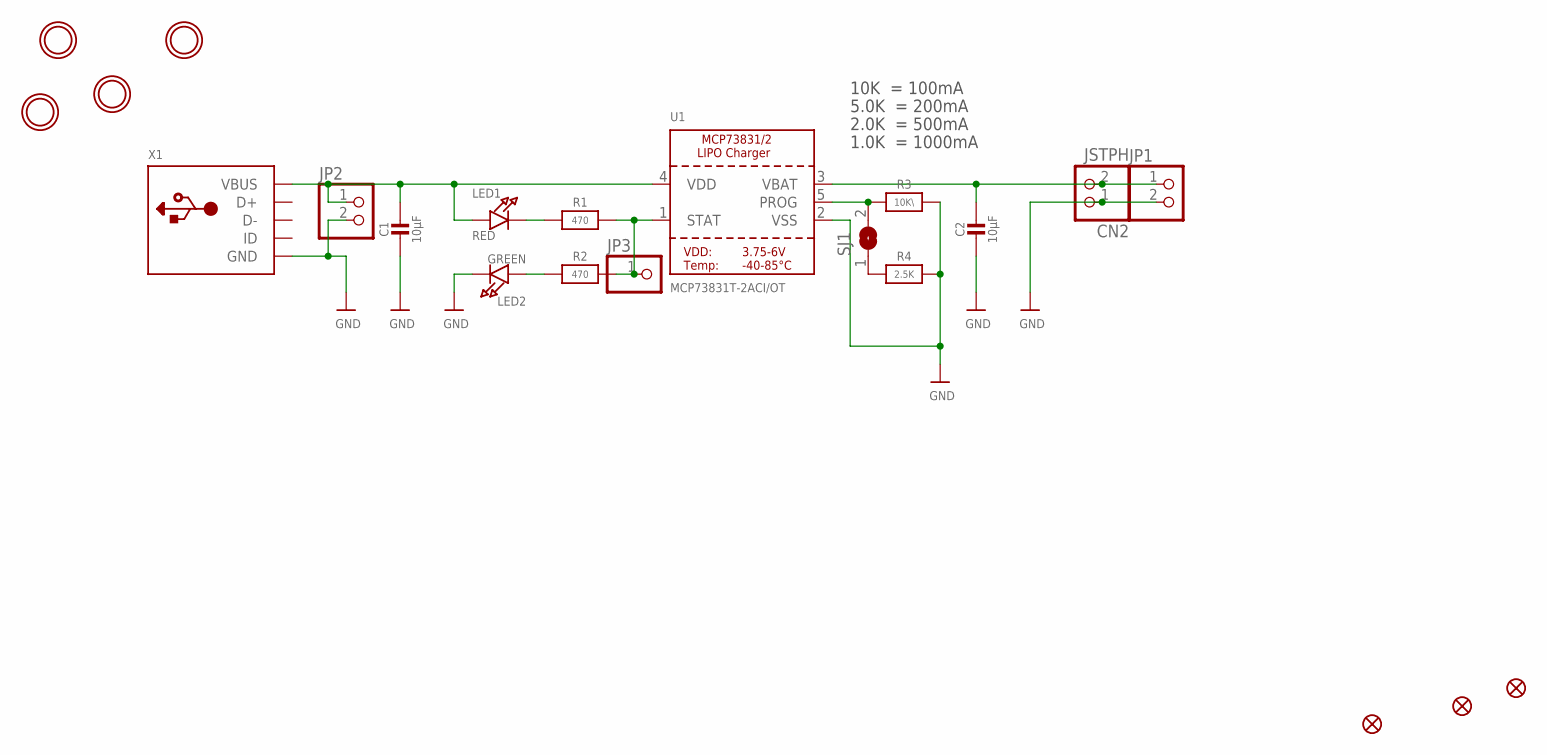
[picture p29: schematic Adafruit MiniLipo.sch]

Parts:
C1, C2: 10µF; 0805-NO
CN2: JSTPH; JSTPH2
FID1, FID2, FID3: FIDUCIAL""; FIDUCIAL_1MM
JP1, JP2: HEADER-1X2ROUND; 1X02_ROUND
JP3: PINHD-1X1CB; 1X01-CLEANBIG
LED1: RED; CHIPLED_0805_NOOUTLINE
LED2: GREEN; CHIPLED_0805_NOOUTLINE
R1, R2: 470; 0805-NO
R3: 10K\; 0805-NO
R4: 2.5K; 0805-NO
SJ1: SOLDERJUMPER; SOLDERJUMPER_ARROW_NOPASTE
U1: MCP73831T-2ACI/OT; SOT23-5
U$9, U$10, U$11, U$12: MOUNTINGHOLE2.5; MOUNTINGHOLE_2.5_PLATED
X1: USB_MEDIUM; USB-MINI_MEDIUM

Connections:
GND: C1.2, C2.2, CN2.1, JP1.2, JP2.2, LED2.C, R3.2, R4.2, U1.2 (VSS), X1.GND, X1.GND1 (GND), X1.GND2 (GND), X1.GND3 (GND), X1.GND4 (GND)
unnamed: LED1.C, R1.1
unnamed: JP3.1, R1.2, R2.2, U1.1 (STAT)
unnamed: R4.1, SJ1.1
unnamed: R3.1, SJ1.2, U1.5 (PROG)
unnamed: LED2.A, R2.1
VBAT: C2.1, CN2.2, JP1.1, U1.3 (VBAT)
VDD: C1.1, JP2.1, LED1.A, U1.4 (VDD), X1.VBUS

Notes on the sheet:
10K = 100mA
5.0K = 200mA
2.0K = 500mA
1.0K = 1000mA

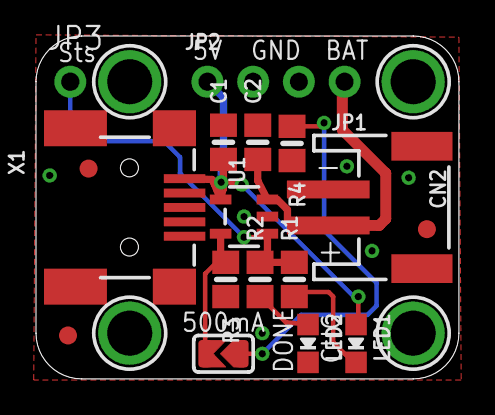
[picture p30: board Adafruit MiniLipo.brd from above]

Board: 2 copper layers, 23.5 x 19.1 mm, 23 parts (1 on the bottom side), 8 nets.

Other parts of the board:
U$13: ADAFRUIT_5MM
