kristofvl/NetWirelessIMU/PCB/Reference_PCBs/ATmega32U4_PCB/Adafruit_Feather_32u4_Basic_Proto/Adafruit_Feather_32u4_Eagle_Files/Adafruit Feather 32u4 Basic rev B.brd

## EAGLE design PCB/Reference_PCBs/ATmega32U4_PCB/Adafruit_Feather_32u4_Basic_Proto/Adafruit_Feather_32u4_Eagle_Files/Adafruit Feather 32u4 Basic rev B.brd (2018-08-24)

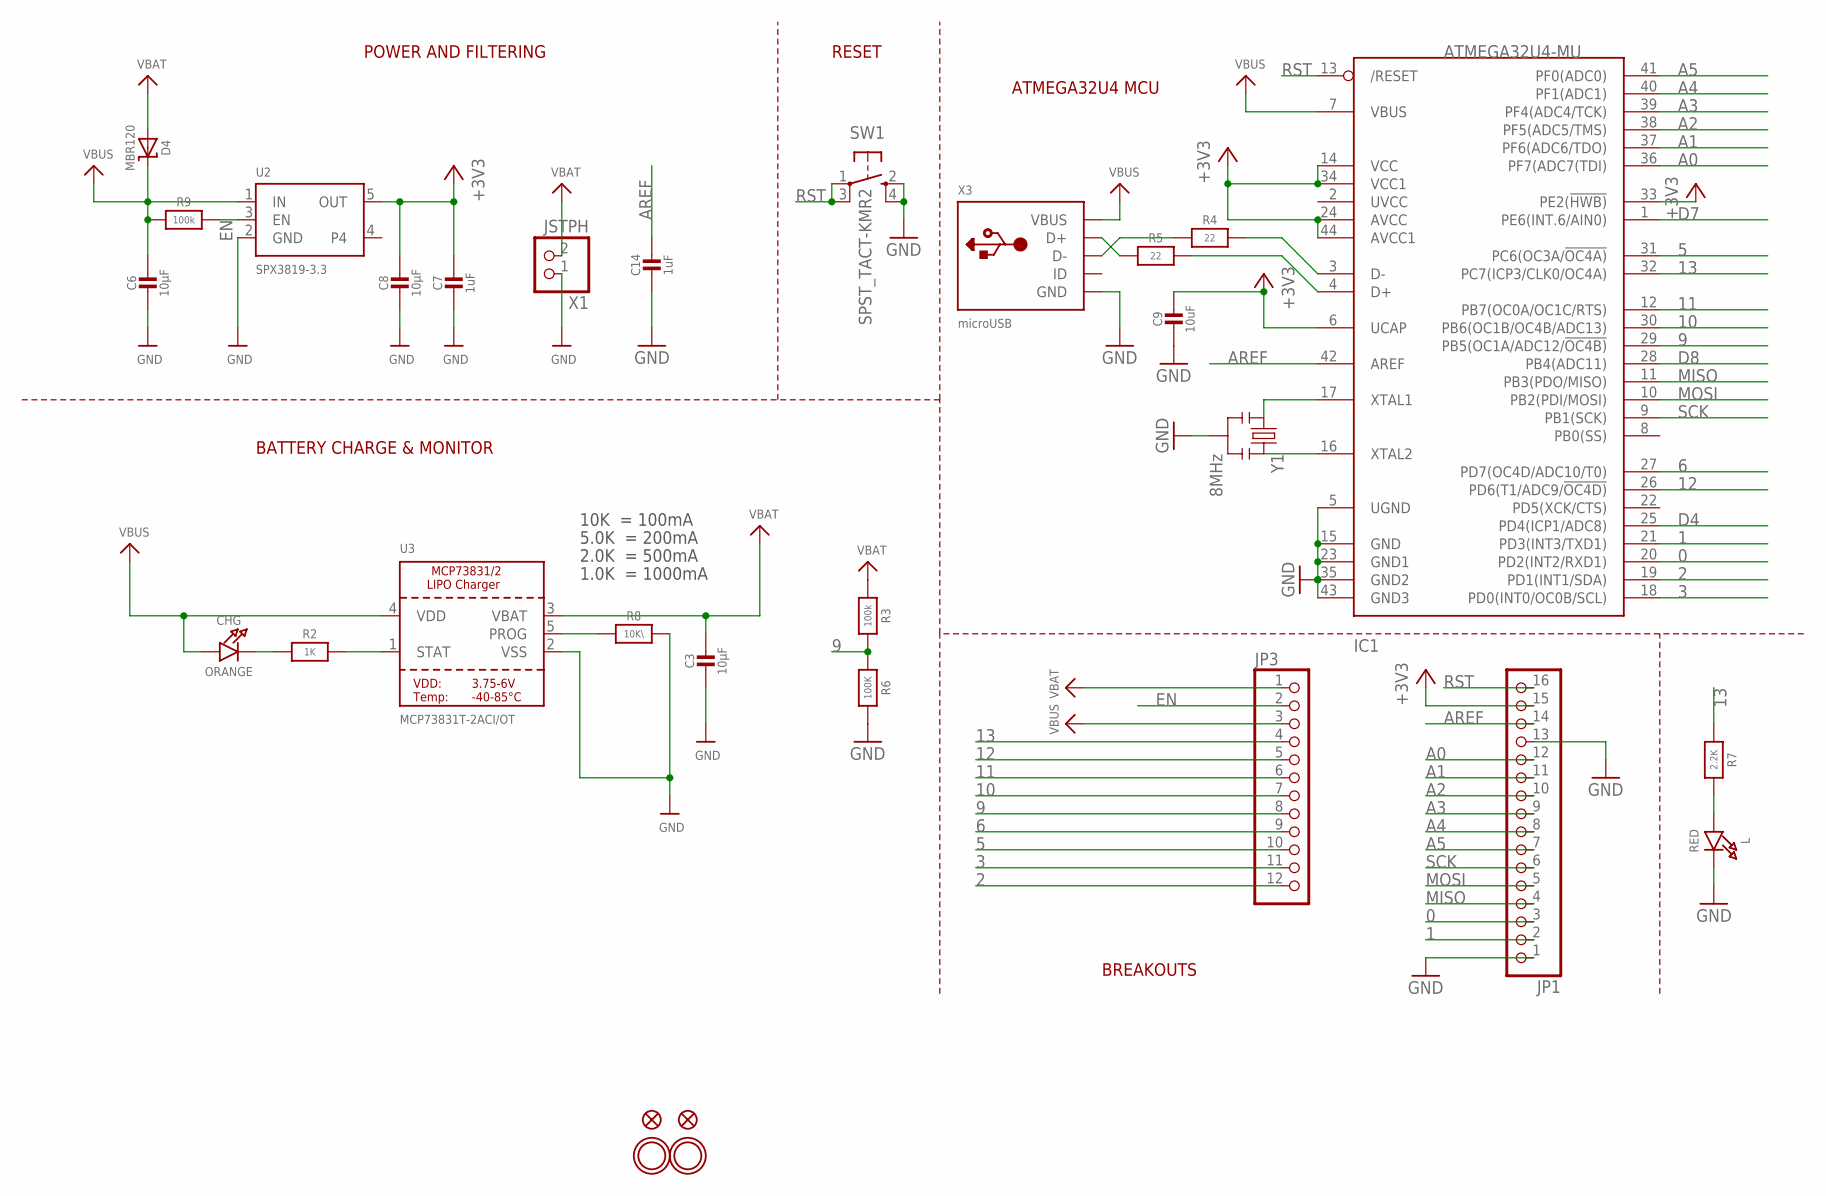
[picture p41: schematic Adafruit Feather 32u4 Basic rev B.sch]

Parts:
C3, C6, C8: 10µF; 0805-NO
C7, C14: 1uF; 0603-NO
C9: 10uF; 0805-NO
CHG: ORANGE; CHIPLED_0805_NOOUTLINE
D4: MBR120; SOD-123
IC1: ATMEGA32U4-MU; TQFN44_7MM
JP1: HEADER-1X16ROUND; 1X16_ROUND
JP3: HEADER-1X12; 1X12_ROUND
L: RED; CHIPLED_0805_NOOUTLINE
R2: 1K; 0603-NO
R3, R9: 100k; 0603-NO
R4, R5: 22; 0603-NO
R6: 100K; _0603MP
R7: 2.2K; 0603-NO
R8: 10K\; 0603-NO
SW1: SPST_TACT-KMR2; KMR2
U2: SPX3819-3.3; SOT23-5
U3: MCP73831T-2ACI/OT; SOT23-5
U$31, U$32: MOUNTINGHOLE2.5; MOUNTINGHOLE_2.5_PLATED
U$34, U$35: FIDUCIAL""; FIDUCIAL_1MM
X1: JSTPH; JSTPH2
X3: microUSB; 4UCONN_20329_V2
Y1: 8MHz; RESONATOR-SMD

Connections:
0: IC1.20 (PD2(INT2/RXD1)), JP1.3
1: IC1.21 (PD3(INT3/TXD1)), JP1.2
2: IC1.19 (PD1(INT1/SDA)), JP3.12
3: IC1.18 (PD0(INT0/OC0B/SCL)), JP3.11
5: IC1.31 (PC6(OC3A/!OC4A)), JP3.10
6: IC1.27 (PD7(OC4D/ADC10/T0)), JP3.9
9: IC1.29 (PB5(OC1A/ADC12/!OC4B)), JP3.8, R3.2, R6.1
10: IC1.30 (PB6(OC1B/OC4B/ADC13)), JP3.7
11: IC1.12 (PB7(OC0A/OC1C/RTS)), JP3.6
12: IC1.26 (PD6(T1/ADC9/!OC4D)), JP3.5
13: IC1.32 (PC7(ICP3/CLK0/OC4A)), JP3.4, R7.1
+3V3: C7.1, C8.1, C9.1, IC1.6 (UCAP), IC1.14 (VCC), IC1.24 (AVCC), IC1.33 (PE2(!HWB)), IC1.34 (VCC1), IC1.44 (AVCC1), JP1.15, U2.5 (OUT)
A0: IC1.36 (PF7(ADC7(TDI)), JP1.12
A1: IC1.37 (PF6(ADC6/TDO)), JP1.11
A2: IC1.38 (PF5(ADC5/TMS)), JP1.10
A3: IC1.39 (PF4(ADC4/TCK)), JP1.9
A4: IC1.40 (PF1(ADC1)), JP1.8
A5: IC1.41 (PF0(ADC0)), JP1.7
AREF: C14.1, IC1.42 (AREF), JP1.14
D4: IC1.25 (PD4(ICP1/ADC8))
D7: IC1.1 (PE6(INT.6/AIN0))
D8: IC1.28 (PB4(ADC11))
D+: IC1.4 (D+), R5.2
D-: IC1.3 (D-), R4.2
EN: JP3.2, R9.2, U2.3 (EN)
GND: C3.2, C6.2, C7.2, C8.2, C9.2, C14.2, IC1.5 (UGND), IC1.15 (GND), IC1.23 (GND1), IC1.35 (GND2), IC1.43 (GND3), JP1.1, JP1.13, L.C, R6.2, R8.2, SW1.2 (S), SW1.4 (S1), U2.2 (GND), U3.2 (VSS), X1.1, X3.BASE@1 (GND), X3.BASE@2 (GND), X3.GND, X3.SPRT@1 (GND), X3.SPRT@2 (GND), X3.SPRT@3 (GND), X3.SPRT@4 (GND), Y1.2
MISO: IC1.11 (PB3(PDO/MISO)), JP1.4
MOSI: IC1.10 (PB2(PDI/MOSI)), JP1.5
unnamed: CHG.C, R2.1
unnamed: L.A, R7.2
unnamed: R2.2, U3.1 (STAT)
unnamed: R8.1, U3.5 (PROG)
unnamed: IC1.16 (XTAL2), Y1.3
unnamed: IC1.17 (XTAL1), Y1.1
unnamed: R5.1, X3.D+
unnamed: R4.1, X3.D-
RST: IC1.13 (/RESET), JP1.16, SW1.1, SW1.3 (P1)
SCK: IC1.9 (PB1(SCK)), JP1.6
VBAT: C3.1, D4.A, JP3.1, R3.1, U3.3 (VBAT), X1.2
VBUS: C6.1, CHG.A, D4.C, IC1.7 (VBUS), JP3.3, R9.1, U2.1 (IN), U3.4 (VDD), X3.VBUS

Notes on the sheet:
POWER AND FILTERING
RESET
ATMEGA32U4 MCU
10K = 100mA
5.0K = 200mA
2.0K = 500mA
1.0K = 1000mA
BATTERY CHARGE & MONITOR
BREAKOUTS

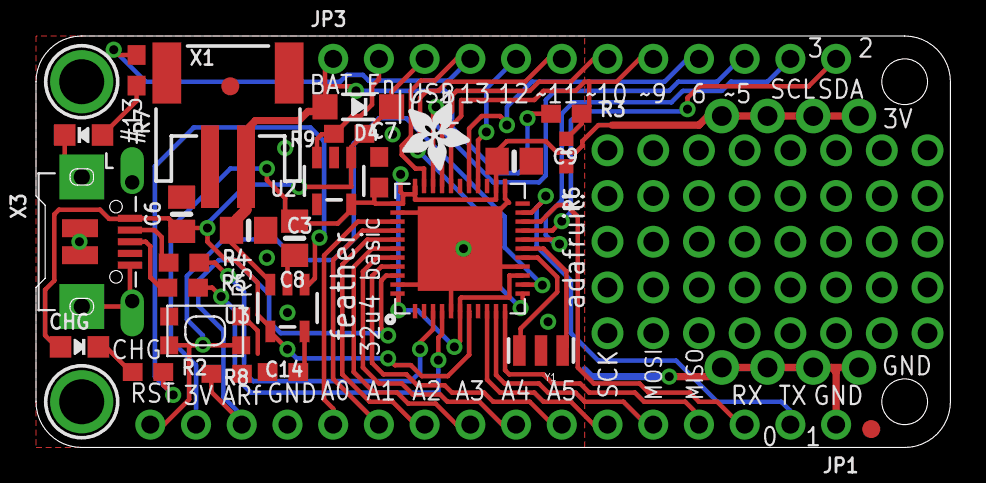
[picture p42: board Adafruit Feather 32u4 Basic rev B.brd from above]

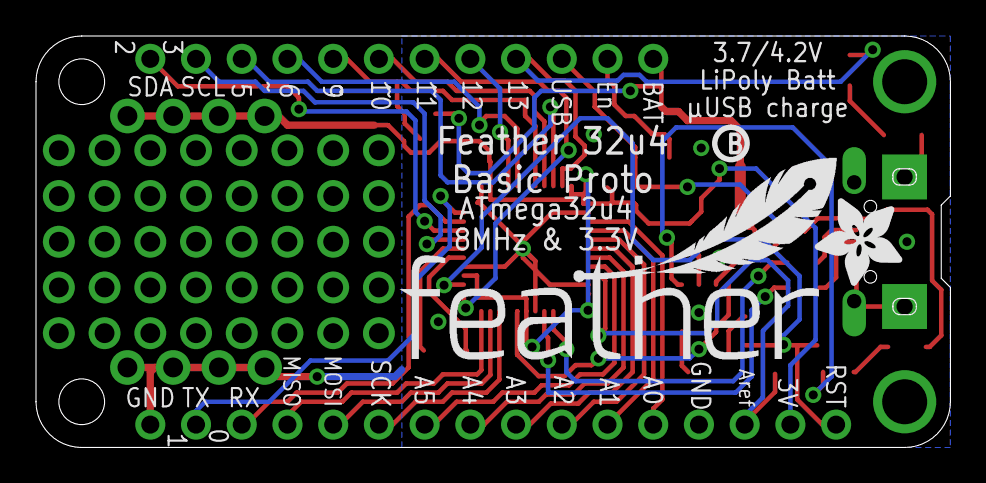
[picture p43: board Adafruit Feather 32u4 Basic rev B.brd from below]

Board: 2 copper layers, 50.8 x 22.9 mm, 34 parts (3 on the bottom side), 37 nets.

Other parts of the board:
U$4: ADAFRUIT_5MM
U$5: FEATHERLOGO
U$6: PCBFEAT-REV-040
U$7: ADAFRUIT_3.5MM
