kristofvl/NetWirelessIMU/PCB/Reference_PCBs/MCP73831_LiPo_Charger_PCB/Sparkfun_MiniLipo/Sparkfun_MiniLipo_Eagle_Files/SparkFun_LiPo-Charger-Basic-MiniUSB.brd

## EAGLE design PCB/Reference_PCBs/MCP73831_LiPo_Charger_PCB/Sparkfun_MiniLipo/Sparkfun_MiniLipo_Eagle_Files/SparkFun_LiPo-Charger-Basic-MiniUSB.brd (2018-08-24)

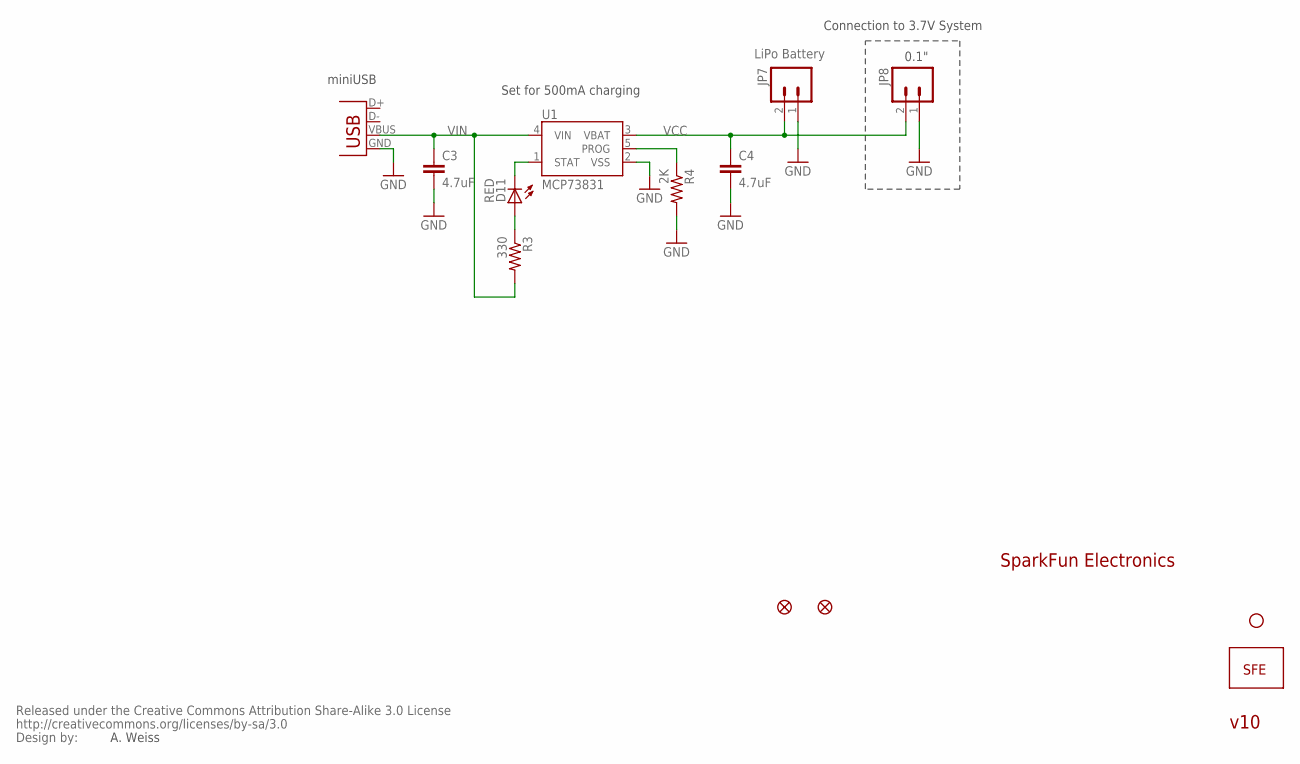
[picture p44: schematic SparkFun_LiPo-Charger-Basic-MiniUSB.sch]

Parts:
C3, C4: 4.7uF; 0402-CAP
D11: RED; LED-0603
JP1: LOGO-SFESK; SFE-LOGO-FLAME
JP2: STAND-OFF
JP3, JP4: FIDUCIAL1X2; FIDUCIAL-1X2
JP7: LiPo Battery; JST-2-SMD
JP8: M02PTH; 1X02
R3: 330; 0402-RES
R4: 2K; 0402-RES
U1: MCP73831; SOT23-5
U$1: CREATIVE_COMMONS
X1: Micro USB; USB-MINIB

Connections:
GND: C3.2, C4.2, JP7.1, JP8.1, R4.2, U1.2 (VSS), X1.GND
unnamed: D11.A, R3.1
PROG: R4.1, U1.5 (PROG)
STAT: D11.C, U1.1 (STAT)
VCC: C4.1, JP7.2, JP8.2, U1.3 (VBAT)
VIN: C3.1, R3.2, U1.4 (VIN), X1.VBUS

Notes on the sheet:
Set for 500mA charging
Connection to 3.7V System
0.1"
A. Weiss
miniUSB
v10
SparkFun Electronics

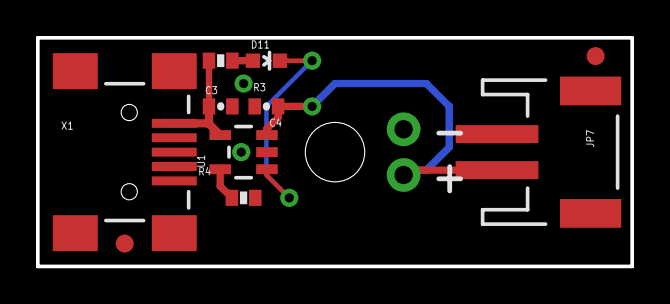
[picture p45: board SparkFun_LiPo-Charger-Basic-MiniUSB.brd from above]

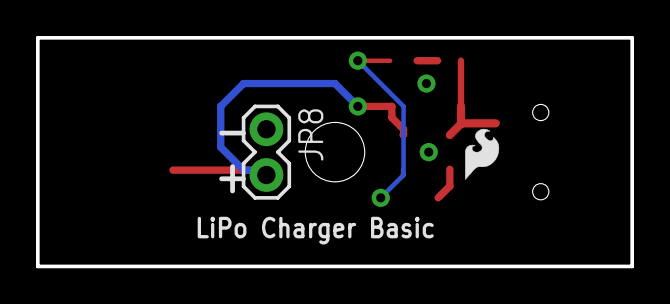
[picture p46: board SparkFun_LiPo-Charger-Basic-MiniUSB.brd from below]

Board: 2 copper layers, 33.0 x 12.7 mm, 14 parts (2 on the bottom side), 6 nets.
