kristofvl/NetWirelessIMU/AVR/Test_nRF24L01_RX/Test_nRF24L01_RX/main.c

/*
 * Test_nRF24L01_RX.c
 *
 * Created: 07-Jun-18 10:16:04 AM
 * Author : Frederic Philips
 */ 

#include <avr/io.h>
#include <avr/sfr_defs.h>
#define F_CPU 16000000UL //16 MHz frequency
#define BAUD  9600
#include <util/setbaud.h>
#include <util/delay.h>

#include "Test_nRF24L01_RX.h"

//Bit macros
#define _BV(bit)	(1 << (bit))
#define _NBV(bit)	(0 << (bit))

//SPI macros
#define SPI_PORT	PORTB
#define SPI_DDR		DDRB
#define MOSI		2
#define MISO		3
#define SCLK		1
#define CSN		5
#define CE		4

//UART macros
#define UART_PORT	PORTD
#define UART_DDR	DDRD

//nRF control macros
#define CE_LOW()	SPI_PORT &= ~(_BV(CE))
#define CE_HIGH()	SPI_PORT |= _BV(CE)
#define CSN_LOW()	SPI_PORT &= ~(_BV(CSN))
#define CSN_HIGH()	SPI_PORT |= _BV(CSN)

void AVR_Init(void);
void SPI_Init(void);
uint8_t SPI_Write_Byte(uint8_t byte);
void UART_Init(void);
void nRF24L01_Init(void);
void nRF24L01_Config(void);
void nRF24L01_DR_Setup(uint8_t data_rate);
void nRF24L01_OP_Power(uint8_t op_power);
void nRF24L01_Write_Reg(uint8_t reg, uint8_t data);
void nRF24L01_Write_Regs(uint8_t reg, uint8_t *data, uint8_t len);
uint8_t nRF24L01_Read_Reg(uint8_t reg);
void nRF24L01_Read_Regs(uint8_t reg, uint8_t *data, uint8_t len);
void nRF24L01_Payload_RX(uint8_t *RX_pld_data);
uint8_t nRF24L01_RX_DR_Flag();
uint8_t nRF24L01_RX_FIFO_Empty();
void nRF24L01_Mode(uint8_t nRF_mode);
void UART_Tx(unsigned char data);

//Define 5-byte unique addresses for TX and RX
uint8_t TX_address[5] = {0x55, 0x55, 0x55, 0x55, 0x55};
uint8_t RX_address[5] = {0xAA, 0xAA, 0xAA, 0xAA, 0xAA};

//Define array for RX payload(Max. 32 bytes)
uint8_t RX_payload[32];
	
//Initialize the AVR
void AVR_Init(void)
{
	_delay_ms(500);		//Short pause
}

/************************************************************************************
** USART Reference:
** - ATmega32U4 Datasheet - Rev. CORP072610(Pg.186)
** - AVR Microcontroller and Embedded Systems - Mazidi(Pg.395)
** - Embedded C Programming and the Atmel AVR - Barnett(Pg.132)
*************************************************************************************
** To initialize the UART, the following steps are to be followed:
** - Set the Baud rate(use <util/setbaud.h>, which depends on the macros F_CPU & BAUD)
** - Disable double speed(2x) mode
** - Set the no. of data bits(8/9 bits), stop bit(1/2) and parity bit(None/Odd/Even)
** - Set the USART mode(Synchronous/Asynchronous/Asynchronous 2x)
** - Enable Receiver & Transmitter(Set RXEN & TXEN bits in UCSRB register)
*************************************************************************************/
//Initialize the UART
void UART_Init(void)
{
	//Initialize the I/O peripherals
	UART_DDR |= _BV(1);	//Set TX as output
	UART_DDR &= ~(_BV(0));	//Set RX as input
	
	//Set the BAUD rate(Ref. ATmega32U4 Datasheet Pg.189, Table 18-1)
	//To hard-code the Baud rate, Ref. Tables 18-9 to 18-12 in Pgs. 210 - 213
	UBRR1 = ((F_CPU / (16UL * BAUD)) - 1);
	
	//Disables 2x speed
	UCSR1A &= ~(_BV(U2X1));
	
	//Enable 8-bit character size, one stop-bit, no parity & asynchronous mode
	UCSR1C |= _BV(UCSZ11) | _BV(UCSZ10);
	
	//Enable Transmitter & Receiver
	UCSR1B |= _BV(TXEN1) | _BV(RXEN1);
}	
	
/* nRF24L01 max. clock speed = 8MHz
** Note: From ATMega32U4 datasheet:
** To ensure correct sampling of the clock signal, the frequency 
** of the SPI clock should never exceed F_CPU/4.
*/
//Initialize the SPI
void SPI_Init(void)
{
	//Initialize the SPI hardware pins
	SPI_DDR |= _BV(MOSI) | _BV(SCLK);
	SPI_DDR &= ~(_BV(MISO));
	
	//Enable SPI in Master mode with data-rate @F_CPU/4
	SPCR |= _BV(SPE) | _BV(MSTR);
}

/*
** Note: 
** nRF requires typically 5.3ms settling time after POR.
** When nRF24L01 is in power down mode it must settle for 1.5ms 
** before it can enter the TX or RX modes. 
** If an external clock is used this delay is reduced to 150?s.
** CE should be held low/high for a minimum of 10?s.
** The settling time must be controlled by the MCU.
*/
//Initialize the nRF module
void nRF24L01_Init(void)
{
	//Initialize the nRF control pins
	SPI_DDR |= _BV(CSN) | _BV(CE);
	
	//Set CE low and CSN high
	CE_LOW();
	CSN_HIGH();
	
	_delay_us(10);	//Delay for CE settling time
}

//Configure the nRF module
void nRF24L01_Config(void)
{
	/************************************************************************/
	/*			      Debug Zone                                */
	/************************************************************************/
	uint8_t reg_value = nRF24L01_Read_Reg(NRF24L01_REG_STATUS);
	UART_Tx(reg_value);
	
	/************************************************************************/
	/*                             RF Setup                                 */
	/************************************************************************/
	
	//Set the RF channel to 105 i.e. @2.505 GHz
	nRF24L01_Write_Reg(NRF24L01_REG_RF_CH, NRF24L01_CHANNEL);
	
	/************************************************************************/
	/*			      Debug Zone                                */
	/************************************************************************/
	reg_value = nRF24L01_Read_Reg(NRF24L01_REG_RF_CH);
	UART_Tx(reg_value);
	
	//Set the data rate to 2 MBPS
	nRF24L01_DR_Setup(NRF24L01_DR_2_MBPS);
	
	//Set the output power to 0dBM
	nRF24L01_OP_Power(NRF24L01_OP_POWER_POS_0dBM);
	
	//LNA setting is unavailable in nRF24L01+
	
	/************************************************************************/
	/*                          Payload config                              */
	/************************************************************************/
	
	//Enable data-pipe 0 with a payload length of 1 byte
	nRF24L01_Write_Reg(NRF24L01_REG_RX_PW_P0, NRF24L01_PAYLOAD_LEN);
	
	//Disable dynamic payload
	nRF24L01_Write_Reg(NRF24L01_REG_DYNPD, 0x00);
	
	/************************************************************************/
	/*                          Address config                              */
	/************************************************************************/
	
	//Address width set to 5 bytes
	nRF24L01_Write_Reg(NRF24L01_REG_SETUP_AW, NRF24L01_ADDRESS_WIDTH);
	
	//Set the 5-byte receiver address from RX_address array
	nRF24L01_Write_Regs(NRF24L01_REG_RX_ADDR_P0, RX_address, 5);
	
	//Set the 5-byte transmitter address from TX_address array
	nRF24L01_Write_Regs(NRF24L01_REG_TX_ADDR, TX_address, 5);
	
	/************************************************************************/
	/*			   Data verification                            */
	/************************************************************************/
	
	//Enable auto-acknowledgment for the data-pipe in use(data-pipe 0)
	nRF24L01_Write_Reg(NRF24L01_REG_EN_AA, _BV(NRF24L01_REG_ENAA_P0));
	
	//Disable auto-retry
	nRF24L01_Write_Reg(NRF24L01_REG_SETUP_RETR, NRF24L01_RETRY_COUNT);
	
	//Enable CRC and set the length to 1 byte
	nRF24L01_Write_Reg(NRF24L01_REG_CONFIG, NRF24L01_DEFAULT_CONFIG);
	
	/************************************************************************/
	/*			   Transceiver mode                             */
	/************************************************************************/
	
	//Set the nRF in receiver mode
	nRF24L01_Mode(NRF24L01_RX_MODE);
}

//Set the nRF data rate
void nRF24L01_DR_Setup(uint8_t data_rate)
{
	uint8_t nRF_DR_value = nRF24L01_Read_Reg(NRF24L01_REG_RF_SETUP);
	switch(data_rate)
	{
		//250 KBPS
		case NRF24L01_DR_250_KBPS:
			nRF_DR_value &= ~(_BV(NRF24L01_REG_RF_DR_HIGH));
			nRF_DR_value |= _BV(NRF24L01_REG_RF_DR_LOW);
			break;
		
		//1 MBPS
		case NRF24L01_DR_1_MBPS:
			nRF_DR_value &= ~(_BV(NRF24L01_REG_RF_DR_HIGH));
			nRF_DR_value &= ~(_BV(NRF24L01_REG_RF_DR_LOW));
			break;
		
		//2 MBPS
		case NRF24L01_DR_2_MBPS:
			nRF_DR_value |= _BV(NRF24L01_REG_RF_DR_HIGH);
			nRF_DR_value &= ~(_BV(NRF24L01_REG_RF_DR_LOW));
			break;
	}
	
	nRF24L01_Write_Reg(NRF24L01_REG_RF_SETUP, nRF_DR_value);
}

//Set the nRF output power
void nRF24L01_OP_Power(uint8_t op_power)
{
	uint8_t nRF_power_value = nRF24L01_Read_Reg(NRF24L01_REG_RF_SETUP);
	switch(op_power)
	{
		//-18dBM
		case NRF24L01_OP_POWER_NEG_18dBM:
			nRF_power_value &= ~(_BV(NRF24L01_REG_RF_PWR_0));
			nRF_power_value &= ~(_BV(NRF24L01_REG_RF_PWR_1));
			break;
		
		//-12dBM
		case NRF24L01_OP_POWER_NEG_12dBM:
			nRF_power_value |= _BV(NRF24L01_REG_RF_PWR_0);
			nRF_power_value &= ~(_BV(NRF24L01_REG_RF_PWR_1));
			break;
		
		//-6dBM
		case NRF24L01_OP_POWER_NEG_6dBM:
			nRF_power_value &= ~(_BV(NRF24L01_REG_RF_PWR_0));
			nRF_power_value |= _BV(NRF24L01_REG_RF_PWR_1);
			break;
			
		//+0dBM
		case NRF24L01_OP_POWER_POS_0dBM:
			nRF_power_value |= _BV(NRF24L01_REG_RF_PWR_0);
			nRF_power_value |= _BV(NRF24L01_REG_RF_PWR_1);
			break;		
	}
	
	nRF24L01_Write_Reg(NRF24L01_REG_RF_SETUP, nRF_power_value);	
}

//SPI write one byte of data and return the read byte(cyclic)
uint8_t SPI_Write_Byte(uint8_t byte)
{
	//Pull CSN low to start SPI communication
//	CSN_LOW();	
	//Load byte in SPI data register
	SPDR = byte;
	
	
	
	//Wait for transmission to complete
	while (!(SPSR & (1 << SPIF)));
	
//	UART_Tx(0xEE);
	
	//Return the received data
	return SPDR;
	//Pull CSN low to start SPI communication
//	CSN_HIGH();	
}

//Write one byte of data to nRF register
void nRF24L01_Write_Reg(uint8_t reg, uint8_t data)
{	
	//Pull CSN low to start SPI communication
	CSN_LOW();
	
	//Set write access to register
	SPI_Write_Byte(NRF24L01_CMD_W_REGISTER | (NRF24L01_CMD_REGISTER_MASK & reg));
	
//	UART_Tx(0xBB);
	
	//Write data to register		
	SPI_Write_Byte(data);	
	
//	UART_Tx(0xBB);			
	
	//Pull CSN high to stop SPI communication
	CSN_HIGH();	
}

//Write bytes of a specific length of data into nRF register
void nRF24L01_Write_Regs(uint8_t reg, uint8_t *data, uint8_t len)
{
	//Reset the write byte count
	int8_t wByte_cnt = 0;				
	
	//Pull CSN low to start SPI communication
	CSN_LOW();
	
	//Set write access to register
	SPI_Write_Byte(NRF24L01_CMD_W_REGISTER | (NRF24L01_CMD_REGISTER_MASK & reg));

	for(wByte_cnt = 0; wByte_cnt < len; wByte_cnt++)
	{
		//Write data to register
		SPI_Write_Byte(data[wByte_cnt]);
	}
	
	//Pull CSN high to stop SPI communication
	CSN_HIGH();
}

//Read one byte of data from nRF register
uint8_t nRF24L01_Read_Reg(uint8_t reg)
{	
	//Pull CSN low to start SPI communication
	CSN_LOW();
	
	//Set read access to register
	SPI_Write_Byte(NRF24L01_CMD_R_REGISTER | (NRF24L01_CMD_REGISTER_MASK & reg));
	//Send NOP byte to read data from register
	uint8_t reg_data = SPI_Write_Byte(NRF24L01_CMD_NOP);	
	
	//Pull CSN high to stop SPI communication
	CSN_HIGH();	
	
	//Return the read data
	return reg_data;					
}

//Read bytes of a specific length of data from nRF register
void nRF24L01_Read_Regs(uint8_t reg, uint8_t *data, uint8_t len)
{
	//Reset the read byte count
	uint8_t rByte_cnt = 0;				
	
	//Pull CSN low to start SPI communication
	CSN_LOW();
	
	//Set read access to register
	SPI_Write_Byte(NRF24L01_CMD_R_REGISTER | (NRF24L01_CMD_REGISTER_MASK & reg));
	
	for(rByte_cnt = 0; rByte_cnt < len; rByte_cnt++)
	{
		//Send NOP byte to read data from register
		data[rByte_cnt] = SPI_Write_Byte(NRF24L01_CMD_NOP);
	}
	
	//Pull CSN high to stop SPI communication
	CSN_HIGH();
}

//Receives the incoming payload
void nRF24L01_Payload_RX(uint8_t *RX_pld_data)
{
	//Pull CSN low to start SPI communication
	CSN_LOW();
	
	//Send command to read RX payload
	SPI_Write_Byte(NRF24L01_CMD_R_RX_PAYLOAD);
	
	//Reset the RX payload count
	uint8_t RX_pld_cnt = 0;
	
	for(RX_pld_cnt = 0; RX_pld_cnt < NRF24L01_PAYLOAD_CNT; RX_pld_cnt++)
	{
		//Send NOP byte to read data from register
		RX_pld_data[RX_pld_cnt] = SPI_Write_Byte(NRF24L01_CMD_NOP);
		//Send the received payload data via UART
		UART_Tx(RX_pld_data[RX_pld_cnt]);
	}
	
	//Pull CSN high to stop SPI communication
	CSN_HIGH();	
	
	//Reset the status register
	nRF24L01_Write_Reg(NRF24L01_REG_STATUS, _BV(NRF24L01_REG_RX_DR));
}

//Checks the status of the receiver data in the status and FIFO status registers
uint8_t nRF24L01_RX_DR_Flag()
{
	//Get the current value from the status register
	uint8_t nRF_status_value = nRF24L01_Read_Reg(NRF24L01_REG_STATUS);
	
	if(nRF_status_value & (_BV(NRF24L01_REG_RX_DR)))
	{
		return 1;
	}
	
	return !nRF24L01_RX_FIFO_Empty();;	 	
}


//Checks the status of the received data in the FIFO
uint8_t nRF24L01_RX_FIFO_Empty()
{
	//Get the current value from the FIFO status register
	uint8_t nRF_FIFO_status = nRF24L01_Read_Reg(NRF24L01_REG_FIFO_STATUS);
	
	return (nRF_FIFO_status & (_BV(NRF24L01_REG_RX_EMPTY)));
}

//Selects the operation mode of the nRF module
void nRF24L01_Mode(uint8_t nRF_mode)
{
	switch(nRF_mode)
	{
		//Power down mode
		case NRF24L01_POWER_DOWN:
			CE_LOW();
			nRF24L01_Write_Reg(NRF24L01_REG_CONFIG, NRF24L01_DEFAULT_CONFIG);
			break;
		
		//TX mode
		case NRF24L01_TX_MODE:
			nRF24L01_Write_Reg(NRF24L01_REG_STATUS, (_BV(NRF24L01_REG_RX_DR))   | 
								(_BV(NRF24L01_REG_TX_DS))   |
								(_BV(NRF24L01_REG_MAX_RT)));
								
			nRF24L01_Write_Reg(NRF24L01_REG_CONFIG, NRF24L01_DEFAULT_CONFIG     |
								(_BV(NRF24L01_REG_PWR_UP)   |
								_NBV(NRF24L01_REG_PRIM_RX)));
			break;
		
		//RX mode
		case NRF24L01_RX_MODE:
			CSN_LOW();
			SPI_Write_Byte(NRF24L01_CMD_FLUSH_RX);
			CSN_HIGH();

			nRF24L01_Write_Reg(NRF24L01_REG_STATUS, (_BV(NRF24L01_REG_RX_DR))   |
								(_BV(NRF24L01_REG_TX_DS))   |
								(_BV(NRF24L01_REG_MAX_RT)));

			CE_LOW();
			nRF24L01_Write_Reg(NRF24L01_REG_CONFIG, NRF24L01_DEFAULT_CONFIG     |
								(_BV(NRF24L01_REG_PWR_UP)   |
								_BV(NRF24L01_REG_PRIM_RX)));
			CE_HIGH();
			break;
	}	
}

/************************************************************************************
** UART_Tx function:
** - Transmits the ADC data via the USB Serial
** - The data is received & displayed in a Hyperterminal
*************************************************************************************/
//Transmit data via UART
void UART_Tx(unsigned char data)
{
	loop_until_bit_is_set(UCSR1A, UDRE1);	//Wait until buffer is empty
	UDR1 = data;				//Send data
}

//Main function
int main(void)
{
	//Initialize the AVR and peripherals
	AVR_Init();
	SPI_Init();
	UART_Init();
	
//	UART_Tx(0xDD);
	
	//Initialize and configure the nRF module
	nRF24L01_Init();
	
//	UART_Tx(0xDD);
	
	nRF24L01_Config();
	
//	UART_Tx(0xDD);
	
	//Loop forever
	while(1) 
	{
//		UART_Tx(0xEE);
//		if(nRF24L01_RX_DR_Flag())
//		{
//			nRF24L01_Payload_RX(RX_payload);
//		}		
	}
}
