kristofvl/NetWirelessIMU/(commit log)

2017-12-11 Time in milliseconds linux C code added
    Uses clock_gettime function
2018-05-15 AVR Blinky, Adc & UART test codes
2018-06-12 Corrected logical error in setting RX pin as input
    [main.c]
2018-06-19 Added reference folder with nRF_Config flowchart
2018-06-20 Added registers and bits' info to nRF_Config flowchart
2018-06-20 Added flowchart for nRF test
2018-08-24 Added PCB Reference files
    [Adafruit BNO055.brd, Adafruit BNO055.sch, Adafruit Feather 32u4 Basic rev B.brd, Adafruit Feather 32u4 Basic rev B.sch, Adafruit MiniLipo.brd, Adafruit MiniLipo.sch, Arduino-Fio_v31.brd, Arduino-Fio_v31.sch]
2018-08-29 Added block diagrams for IMU and eGlove PCBs
2018-09-07 Added IMU_node PCB design files
    [imu_node.brd, imu_node.sch]
2018-09-11 Added latest version of IMU node PCB
    [imu_node.brd, imu_node.sch]
2018-09-14 Added the first version of IMU_node, IMU_finger & IMU_hand PCBs
    [imu_finger.brd, imu_finger.sch, imu_hand.brd, imu_hand.sch, imu_node.brd]
2018-09-14 Updated PCB_TODO
2019-04-10 Added the final AVR firmware files
    [Test_APP.componentinfo.xml]
2019-04-10 Added latest PCB files and BOM
    [Adafruit BNO055.brd, Adafruit BNO055.sch, Adafruit Feather 32u4 Basic rev B.brd, Adafruit Feather 32u4 Basic rev B.sch, Adafruit MiniLipo.brd, Adafruit MiniLipo.sch, Arduino-Fio_v31.brd, Arduino-Fio_v31.sch]
2020-11-25 Added LED blinking for finger tip debugging
2025-05-15 reorganised directories to avoid duplication
    [2020-06-01_01-40-08.csv, 2020-06-01_02-33-34.csv, 2020-06-01_05-31-58.csv, 2020-06-01_05-33-06.csv, 2020-06-01_23-45-55.csv, 2020-06-01_23-46-14.csv, 2020-06-01_23-52-58.csv, 2020-06-02_05-42-47.csv]
